w0rxbend/worxboard-ergo/docs/README.md

# Documentation

Revision A0 is an engineering preview. The case can be printed. The PCB cannot be ordered.

## Guides

| Page | Use it to |
|---|---|
| [3D print guide](printing.md) | Print the case: files, bed sizes, orientation, test pieces, screws |
| [Build guide](build.md) | Follow the whole shop and bench sequence, including what is blocked |
| [CNC traveler](cnc.md) | Mill the chassis and plate from the STEP files |
| [Assembly plan](assembly.md) | See the order of prototype steps and their gates |
| [Firmware notes](firmware.md) | Build the pinned ZMK image and read the controls |

## Design record

| Page | What it records |
|---|---|
| [Design](design.md) | The layout, the shell, and every case dimension |
| [Electrical](electrical.md) | USB port selection, power, and the flashing override |
| [KiCad seed](pcb-seed.md) | How the unrouted boards are generated |
| [Launch coverage](launch-coverage.md) | What does and does not carry over from System76 Launch |
| [Sources](sources.md) | Upstream references and their pins |
| [BOM](bom.csv) | An illustrative parts list. Not for ordering |

## Evidence

| Page | What it answers |
|---|---|
| [Verification](verification.md) | What has been checked, how, and what has not |
| [Roadmap](roadmap.md) | The gates from A0 to a manufacturing package |
| [Changelog](../CHANGELOG.md) | What changed in each release |
