w0rxbend/worxboard-ergo/docs/electrical.md

# Electronics and USB architecture

A bare RP2040 scans a 4×15 matrix with one 1N4148W diode per key: 48 keys fill ROW0–2 and three places of ROW3. Column -> switch -> diode anode -> diode cathode -> row gives `col2row`. Rows GP0–3 are inputs with pull-down; columns COL0–1 on GP26–27 and COL2–14 on GP8–20 are outputs. GP4 and GP28 are left unconnected. `tools/firmware_layout.py` writes the matrix and display pins of the ZMK board files from `GPIO_NETS` in `pcb/scripts/design.py`. A W25Q128JVSIQ provides 16 MiB of QSPI flash; the final 512 KiB is reserved for settings. A 12 MHz crystal, RP2040 supply decoupling, AP2112K 3.3 V regulator, reset, BOOT and SWD test points are included in the schematic.

| GPIO | Function |
|---|---|
| 0–3 | Matrix ROW0–3 |
| 4 | Not connected |
| 5 / 6 / 7 | LCD CS (active high) / SPI0 SCK / SPI0 MOSI |
| 8–20 | Matrix COL2–14 |
| 21 / 22 | USB mux SEL0 / SEL1 |
| 23 / 24 / 25 | Left / center / right pre-diode VBUS sense |
| 26 / 27 | Matrix COL0 / COL1 |
| 28 | Not connected |
| 29 | Reserved RGB output header; not enabled in firmware |

Each USB-C receptacle has independent CC1/CC2 5.1 kΩ sink resistors, its own D+/D− ESD clamp, and a B5819W diode from its VBUS to VSYS. No host VBUS rails are directly tied. The diode OR permits the controller to remain powered if several inputs are connected. Diode leakage, voltage drop, attach current and transient behavior need measurement; this is not a certified multi-host product. Ground is common; there is no galvanic isolation.

A TI TS3USB3031 isolates the three USB data pairs. Its datasheet truth table is `SEL1:SEL0 = 00 left, 01 center, 10 right, 11 high impedance`. The third differential path is labelled MHL+/− by TI; USB full-speed operation on that path still needs bench verification. Both selector bits have 10 kΩ pull-ups, so the default state is disconnected while RP2040 resets. Each pre-diode VBUS rail is divided by 5.1 kΩ/5.1 kΩ for GPIO detection; the 10.2 kΩ to ground also bleeds Schottky reverse leakage on an unplugged port. At a nominal 5 V input this is 2.5 V; verify input thresholds across supply/tolerance extremes.

The ZMK module polls VBUS, uses the center/left/right priority only when choosing a new input, and retains a selected powered input. It enters high impedance for 25 ms before selecting another input. Masked GPIO writes change both selection bits together. This behavior is tested on the host and compiled for RP2040, but actual mux switching, host enumeration and reconnect behavior require hardware. It is cable-position selection, not a KVM feature or simultaneous multi-host keyboard.

USB inputs operate at USB 2.0 full speed through the RP2040 PHY. No PD, charging, USB 3.x, or peripheral hub is included. The 27 Ω USB series resistors belong close to the RP2040. Each receptacle pair runs on F.Cu over the solid In1.Cu ground plane, 0.22 mm wide with a 0.15 mm gap: about 90 Ω differential on PCBWay's standard 4-layer 1.6 mm build by the IPC-2141A closed form (see `pcb/scripts/rules.py`). The second receptacle pad of each line and the ESD clamp join the pair within a few millimetres of the receptacle. This is a computed figure, not a measured one.

The committed `.kicad_pcb` files have placed parts and **zero tracks**. Routing is in progress; [verification.md](verification.md) records where it stands. There is no fabrication package. No board has been built.

The plate has a 2.6 × 1.1 mm window south of every switch for a later SK6812MINI-E. The schematic does not stuff that chain. GP4 and GP28 are free on this board and could drive a load-switch enable in a later revision; none is fitted. Forty-eight addressable LEDs at about 1 mA each would exceed the 2.5 mA USB suspend budget even when dark, and full-white current is far beyond USB 2.0. The RGB header still exposes VSYS, GP29 and ground for a bench experiment. A populated chain needs a level shifter, per-LED decoupling, a default-off power switch, and a measured current limit before it can be routed. Do not attach an unrestricted LED chain directly to this header.

J6 and J7 are SPDT slide switches (C&K PCM12SMTR, 1.4 mm tall) on the bottom of the board; pin 2 of each is the common. Set both to the 1–2 side (RUN) for normal firmware selection. For ROM flashing, disconnect USB, set both to the 2–3 side (ROM), and use only the center USB input. This fixes SEL0=1 and SEL1=0 while disconnecting the firmware control signals, so ROM USB can work without executing the selector code. Hold BOOT while pressing RESET, then copy UF2 to RPI-RP2. Disconnect USB before setting both back to RUN. The switches are reachable only with the board out of the chassis. Both settings and the throw direction on the flipped footprint must be checked during A1; SWD remains the first bring-up/recovery method. The 1 kΩ firmware-side resistors also limit drive contention while a switch is between positions.

The UF2 is a compiled development artifact, not a claim of working hardware. Do not move J6 or J7 while the board is powered.

```mermaid
flowchart LR
  L[Left USB-C] --> M[3:1 USB data mux]
  C[Center USB-C] --> M
  R[Right USB-C] --> M
  M --> RP[RP2040 + QSPI flash]
  RP --> K[4 x 15 diode matrix]
  RP --> D[Center SPI memory LCD]
  L --> VL[VBUS isolation diode]
  C --> VC[VBUS isolation diode]
  R --> VR[VBUS isolation diode]
  VL --> VS[VSYS / 3.3 V regulator]
  VC --> VS
  VR --> VS
  VS --> RP
```
