w0rxbend/worxboard-ergo/assets/layout.png

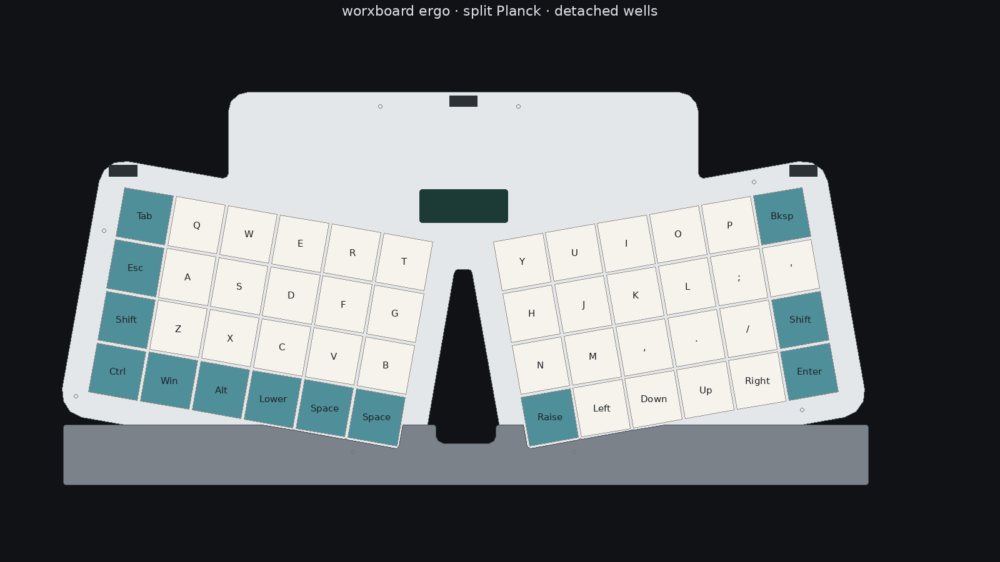
assets/layout.png
