w0rxbend/worxboard-ergo/cad/exports/laser/chassis-underside.png

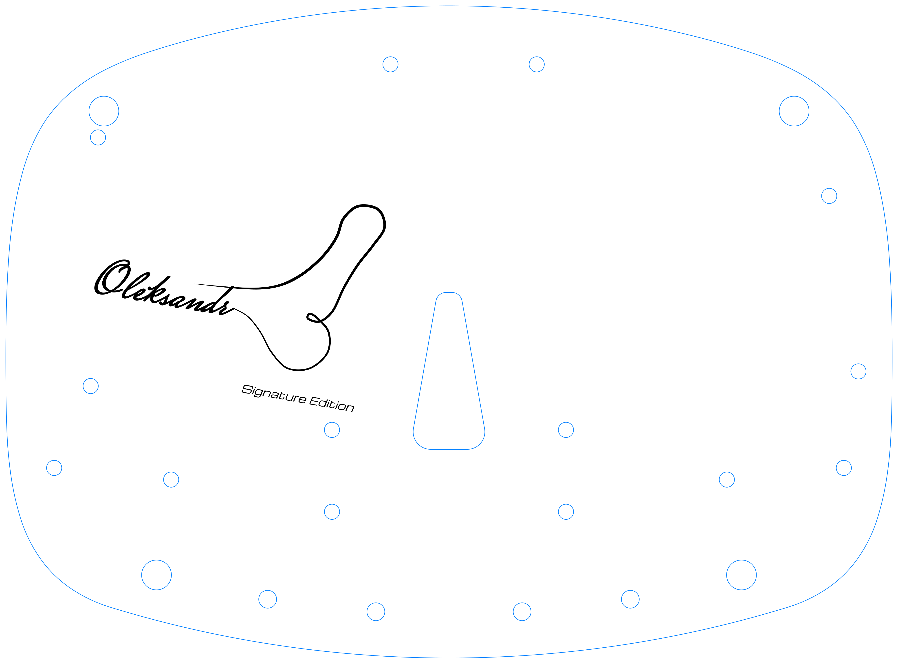
cad/exports/laser/chassis-underside.png
