w0rxbend/worxboard-ergo/cad/exports/laser/signature.png

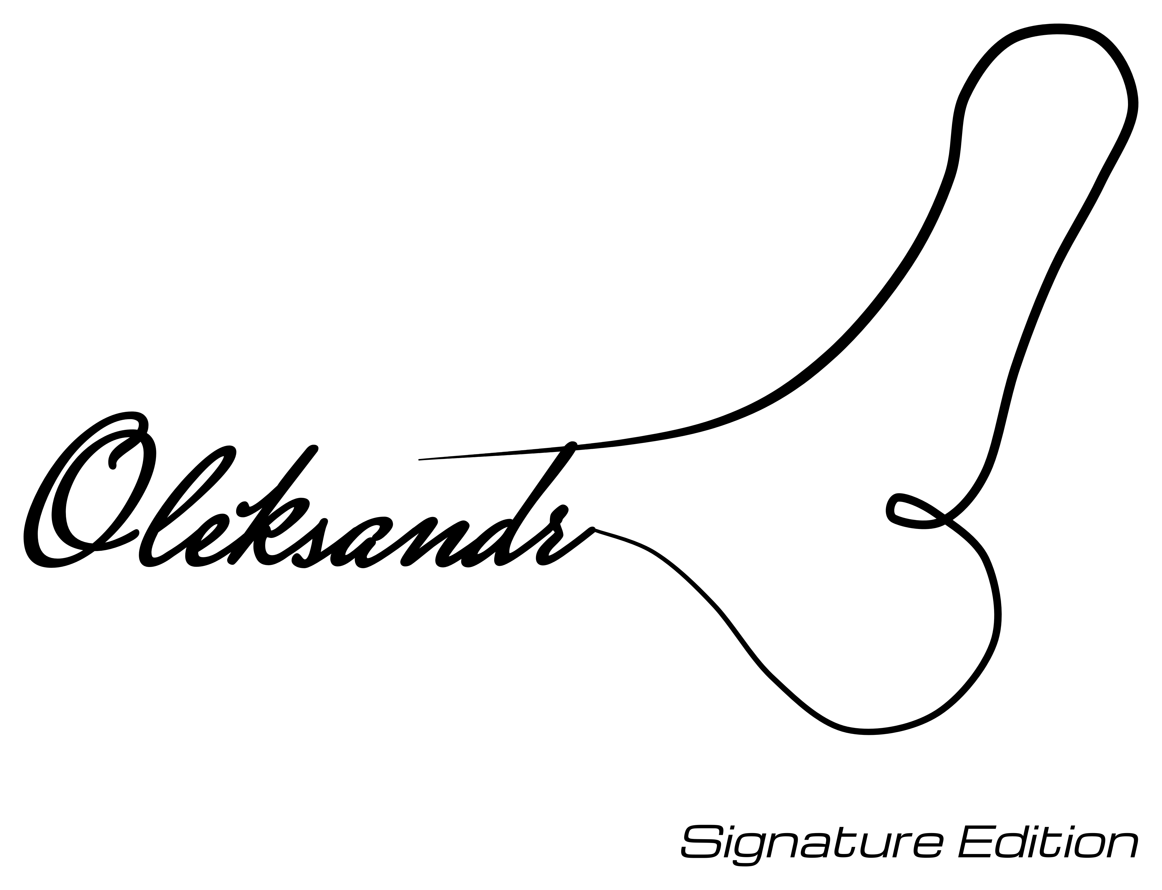
cad/exports/laser/signature.png
