w0rxbend/worxboard-ergo/site/img/choc.png

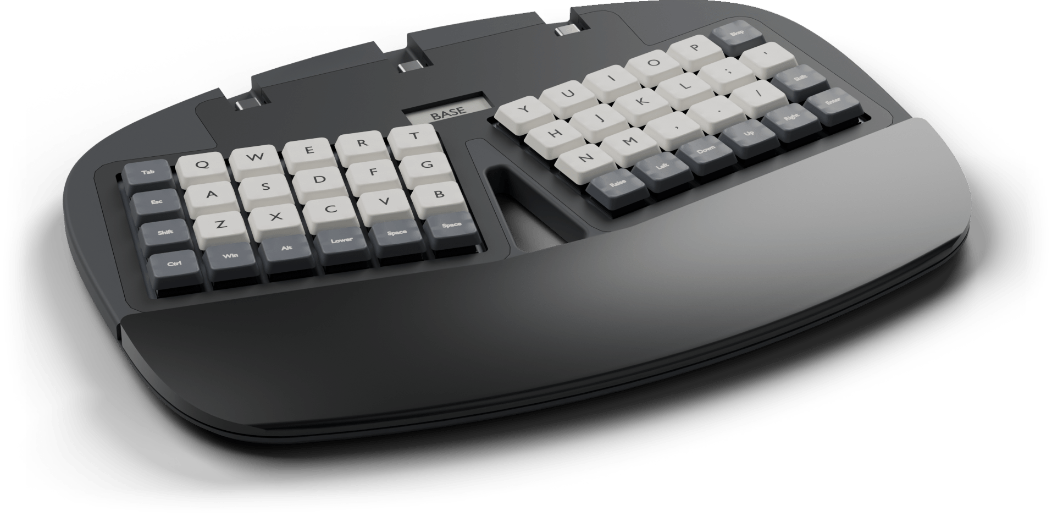
site/img/choc.png
