w0rxbend/worxboard-ergo/site/img/detail-display.png

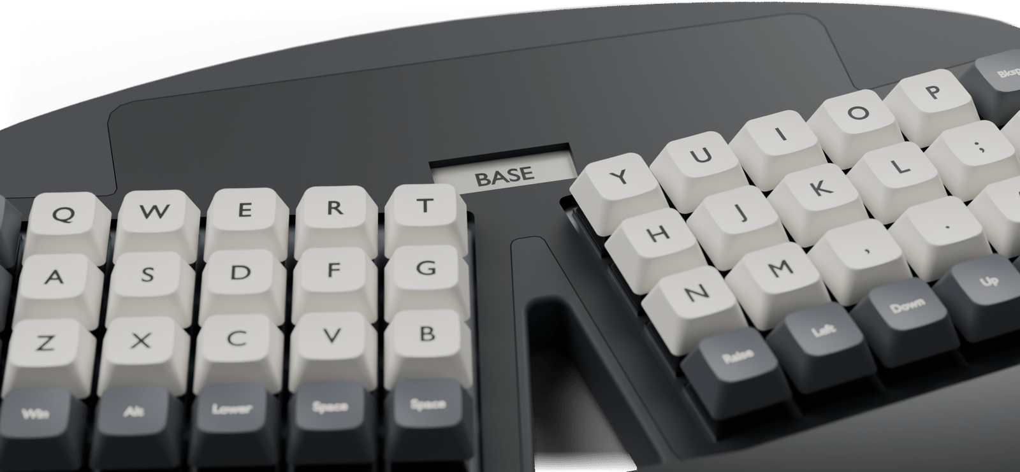
site/img/detail-display.png
