w0rxbend/worxboard-ergo/site/img/detail-legends.png

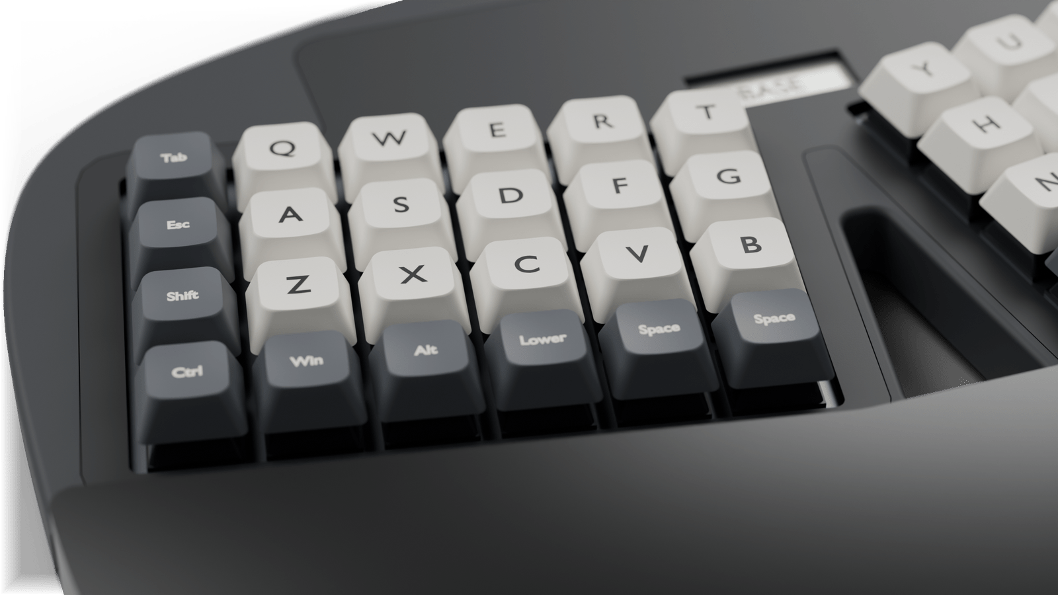
site/img/detail-legends.png
