w0rxbend/worxboard-ergo/site/img/detail-palm.png

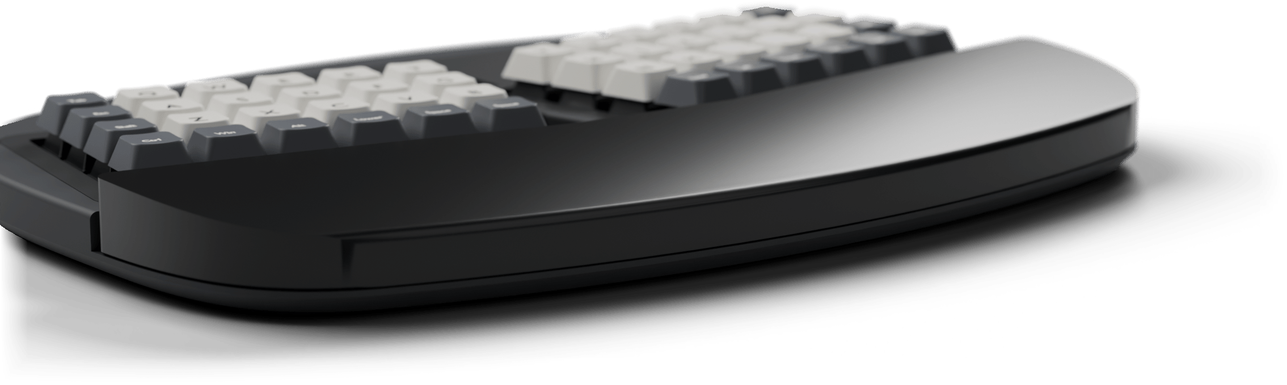
site/img/detail-palm.png
