w0rxbend/worxboard-ergo/site/img/hero.png

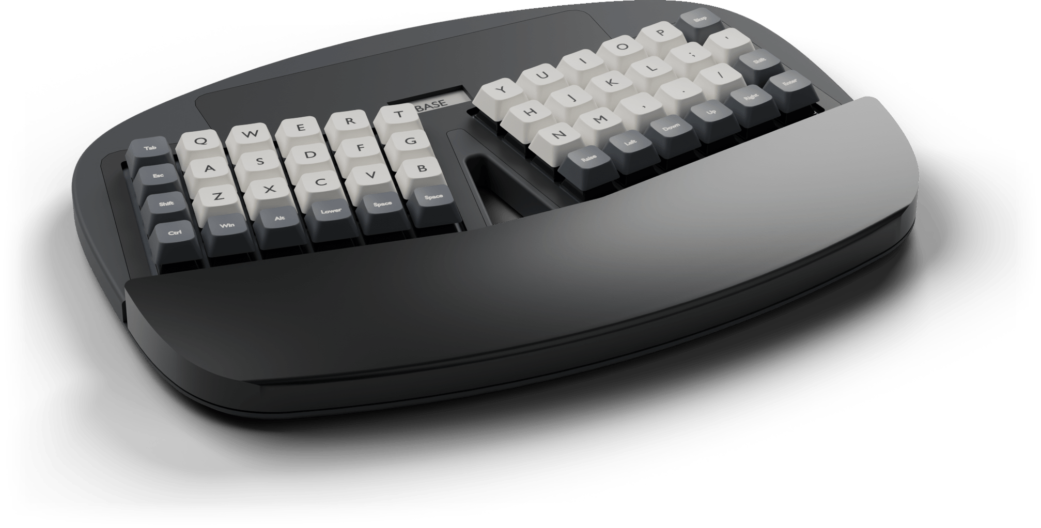
site/img/hero.png
