w0rxbend/worxboard-ergo/site/img/rear.png

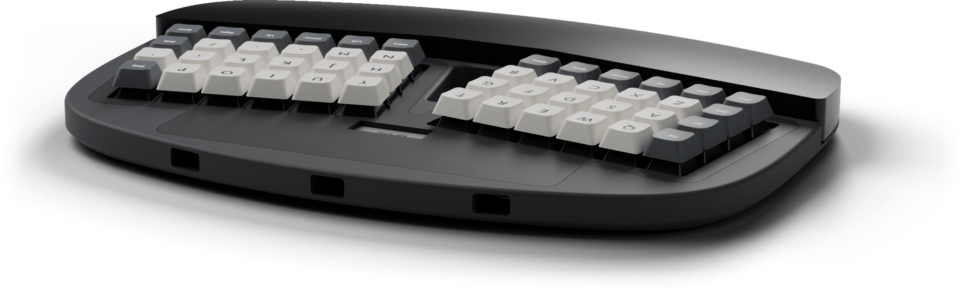
site/img/rear.png
