w0rxbend/worxboard-ergo/site/img/riser.png

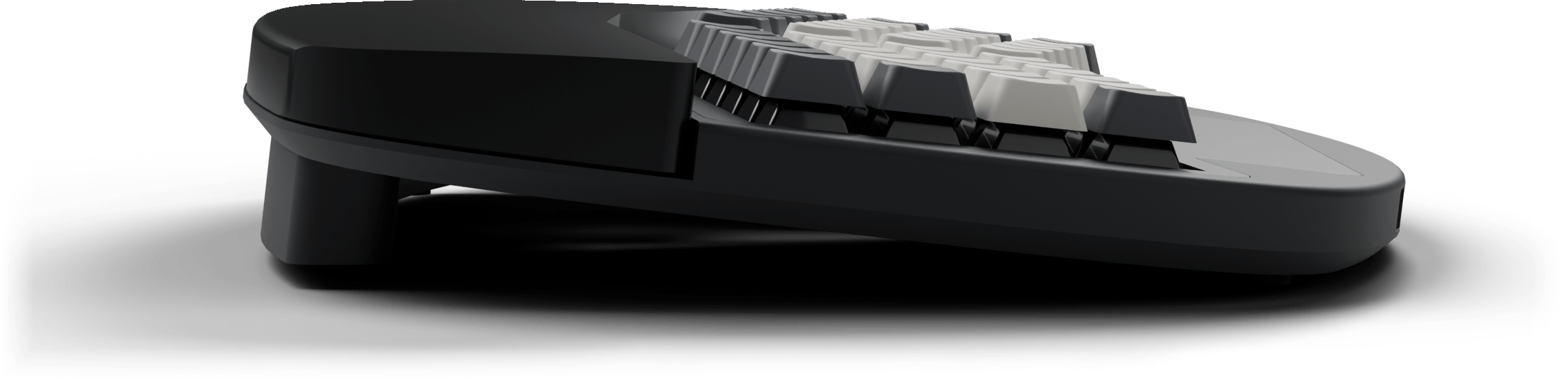
site/img/riser.png
