w0rxbend/worxboard-ergo/site/img/side.png

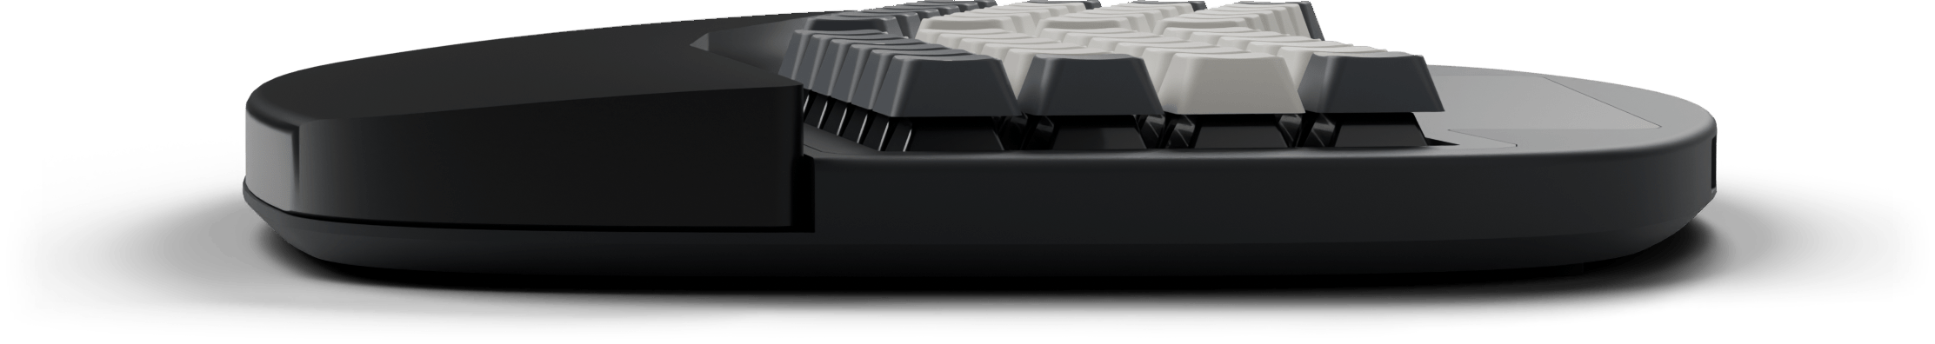
site/img/side.png
