w0rxbend/worxboard-ergo/site/img/top.png

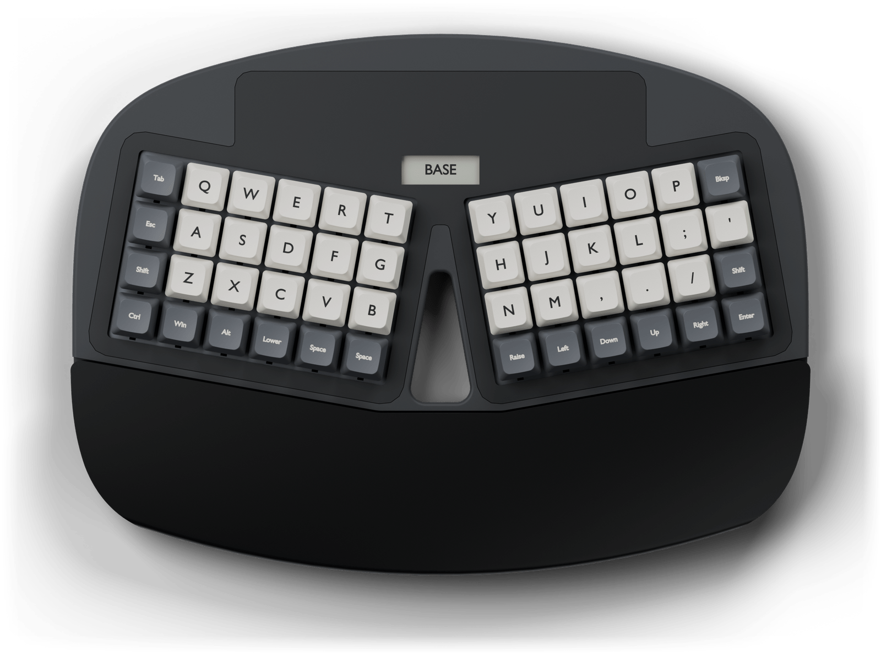
site/img/top.png
