w0rxbend/worxboard-ergo/docs/bom.csv

variant | reference | value | footprint | manufacturer | mpn | LCSC_reference_only | group | fitted_by | status
mx | U1 | RP2040 | Package_DFN_QFN:QFN-56-1EP_7x7mm_P0.4mm_EP3.2x3.2mm | Raspberry Pi | RP2040 | C2040 | MCU | assembler | MPN_READ_2026-11-13_STOCK_AND_PRICE_UNKNOWN
mx | U2 | W25Q128JVSIQ | Package_SO:SOIC-8_5.3x5.3mm_P1.27mm | Winbond | W25Q128JVSIQ | C97521 | MCU | assembler | MPN_READ_2026-11-13_STOCK_AND_PRICE_UNKNOWN
mx | C5 | 100n | Capacitor_SMD:C_0402_1005Metric | Samsung Electro-Mechanics | CL05B104KO5NNNC | C1525 | MCU | assembler | MPN_READ_2026-11-13_STOCK_AND_PRICE_UNKNOWN
mx | Y1 | 12MHz | Crystal:Crystal_SMD_3225-4Pin_3.2x2.5mm | YXC | XL2EL89CRI-111YLC-12M | C49304726 | MCU | assembler | MPN_READ_2026-11-13_STOCK_AND_PRICE_UNKNOWN
mx | R7 | 1k | Resistor_SMD:R_0402_1005Metric | UNI-ROYAL | 0402WGF1001TCE | C11702 | MCU | assembler | MPN_READ_2026-11-13_STOCK_AND_PRICE_UNKNOWN
mx | C6 | 27p | Capacitor_SMD:C_0402_1005Metric | Fenghua | 0402CG270J500NT | C1557 | MCU | assembler | MPN_READ_2026-11-13_STOCK_AND_PRICE_UNKNOWN
mx | C7 | 27p | Capacitor_SMD:C_0402_1005Metric | Fenghua | 0402CG270J500NT | C1557 | MCU | assembler | MPN_READ_2026-11-13_STOCK_AND_PRICE_UNKNOWN
mx | R8 | 10k | Resistor_SMD:R_0402_1005Metric | UNI-ROYAL | 0402WGF1002TCE | C25744 | MCU | assembler | MPN_READ_2026-11-13_STOCK_AND_PRICE_UNKNOWN
mx | R9 | 1k | Resistor_SMD:R_0402_1005Metric | UNI-ROYAL | 0402WGF1001TCE | C11702 | MCU | assembler | MPN_READ_2026-11-13_STOCK_AND_PRICE_UNKNOWN
mx | SW1 | BOOT | Button_Switch_SMD:SW_SPST_TS-1088-xR020 | XUNPU | TS-1088R-02026 | C455280 | MCU | assembler | MPN_READ_2026-11-13_STOCK_AND_PRICE_UNKNOWN
mx | R10 | 10k | Resistor_SMD:R_0402_1005Metric | UNI-ROYAL | 0402WGF1002TCE | C25744 | MCU | assembler | MPN_READ_2026-11-13_STOCK_AND_PRICE_UNKNOWN
mx | SW2 | RESET | Button_Switch_SMD:SW_SPST_TS-1088-xR020 | XUNPU | TS-1088R-02026 | C455280 | MCU | assembler | MPN_READ_2026-11-13_STOCK_AND_PRICE_UNKNOWN
mx | C8 | 100n | Capacitor_SMD:C_0402_1005Metric | Samsung Electro-Mechanics | CL05B104KO5NNNC | C1525 | MCU | assembler | MPN_READ_2026-11-13_STOCK_AND_PRICE_UNKNOWN
mx | C9 | 100n | Capacitor_SMD:C_0402_1005Metric | Samsung Electro-Mechanics | CL05B104KO5NNNC | C1525 | MCU | assembler | MPN_READ_2026-11-13_STOCK_AND_PRICE_UNKNOWN
mx | C10 | 100n | Capacitor_SMD:C_0402_1005Metric | Samsung Electro-Mechanics | CL05B104KO5NNNC | C1525 | MCU | assembler | MPN_READ_2026-11-13_STOCK_AND_PRICE_UNKNOWN
mx | C11 | 100n | Capacitor_SMD:C_0402_1005Metric | Samsung Electro-Mechanics | CL05B104KO5NNNC | C1525 | MCU | assembler | MPN_READ_2026-11-13_STOCK_AND_PRICE_UNKNOWN
mx | C12 | 100n | Capacitor_SMD:C_0402_1005Metric | Samsung Electro-Mechanics | CL05B104KO5NNNC | C1525 | MCU | assembler | MPN_READ_2026-11-13_STOCK_AND_PRICE_UNKNOWN
mx | C13 | 100n | Capacitor_SMD:C_0402_1005Metric | Samsung Electro-Mechanics | CL05B104KO5NNNC | C1525 | MCU | assembler | MPN_READ_2026-11-13_STOCK_AND_PRICE_UNKNOWN
mx | C14 | 100n | Capacitor_SMD:C_0402_1005Metric | Samsung Electro-Mechanics | CL05B104KO5NNNC | C1525 | MCU | assembler | MPN_READ_2026-11-13_STOCK_AND_PRICE_UNKNOWN
mx | C15 | 100n | Capacitor_SMD:C_0402_1005Metric | Samsung Electro-Mechanics | CL05B104KO5NNNC | C1525 | MCU | assembler | MPN_READ_2026-11-13_STOCK_AND_PRICE_UNKNOWN
mx | C16 | 100n | Capacitor_SMD:C_0402_1005Metric | Samsung Electro-Mechanics | CL05B104KO5NNNC | C1525 | MCU | assembler | MPN_READ_2026-11-13_STOCK_AND_PRICE_UNKNOWN
mx | C17 | 100n | Capacitor_SMD:C_0402_1005Metric | Samsung Electro-Mechanics | CL05B104KO5NNNC | C1525 | MCU | assembler | MPN_READ_2026-11-13_STOCK_AND_PRICE_UNKNOWN
mx | C18 | 1u | Capacitor_SMD:C_0402_1005Metric | Samsung Electro-Mechanics | CL05A105KA5NQNC | C52923 | MCU | assembler | MPN_READ_2026-11-13_STOCK_AND_PRICE_UNKNOWN
mx | C19 | 1u | Capacitor_SMD:C_0402_1005Metric | Samsung Electro-Mechanics | CL05A105KA5NQNC | C52923 | MCU | assembler | MPN_READ_2026-11-13_STOCK_AND_PRICE_UNKNOWN
mx | J1 | TYPE-C-31-M-12 | Connector_USB:USB_C_Receptacle_HRO_TYPE-C-31-M-12 | Korean Hroparts Elec | TYPE-C-31-M-12 | C165948 | USB-POWER | assembler | MPN_READ_2026-11-13_STOCK_AND_PRICE_UNKNOWN
mx | R25 | 5.1k | Resistor_SMD:R_0402_1005Metric | UNI-ROYAL | 0402WGF5101TCE | C25905 | USB-POWER | assembler | MPN_READ_2026-11-13_STOCK_AND_PRICE_UNKNOWN
mx | R26 | 5.1k | Resistor_SMD:R_0402_1005Metric | UNI-ROYAL | 0402WGF5101TCE | C25905 | USB-POWER | assembler | MPN_READ_2026-11-13_STOCK_AND_PRICE_UNKNOWN
mx | R27 | 5.1k | Resistor_SMD:R_0402_1005Metric | UNI-ROYAL | 0402WGF5101TCE | C25905 | USB-POWER | assembler | MPN_READ_2026-11-13_STOCK_AND_PRICE_UNKNOWN
mx | R28 | 5.1k | Resistor_SMD:R_0402_1005Metric | UNI-ROYAL | 0402WGF5101TCE | C25905 | USB-POWER | assembler | MPN_READ_2026-11-13_STOCK_AND_PRICE_UNKNOWN
mx | D1 | B5819W | Diode_SMD:D_SOD-123 | JSCJ | B5819W SL | C8598 | USB-POWER | assembler | MPN_READ_2026-11-13_STOCK_AND_PRICE_UNKNOWN
mx | U4 | USBLC6-2SC6 | Package_TO_SOT_SMD:SOT-23-6 | STMicroelectronics | USBLC6-2SC6 | C7519 | USB-POWER | assembler | MPN_READ_2026-11-13_STOCK_AND_PRICE_UNKNOWN
mx | J2 | TYPE-C-31-M-12 | Connector_USB:USB_C_Receptacle_HRO_TYPE-C-31-M-12 | Korean Hroparts Elec | TYPE-C-31-M-12 | C165948 | USB-POWER | assembler | MPN_READ_2026-11-13_STOCK_AND_PRICE_UNKNOWN
mx | R30 | 5.1k | Resistor_SMD:R_0402_1005Metric | UNI-ROYAL | 0402WGF5101TCE | C25905 | USB-POWER | assembler | MPN_READ_2026-11-13_STOCK_AND_PRICE_UNKNOWN
mx | R31 | 5.1k | Resistor_SMD:R_0402_1005Metric | UNI-ROYAL | 0402WGF5101TCE | C25905 | USB-POWER | assembler | MPN_READ_2026-11-13_STOCK_AND_PRICE_UNKNOWN
mx | R32 | 5.1k | Resistor_SMD:R_0402_1005Metric | UNI-ROYAL | 0402WGF5101TCE | C25905 | USB-POWER | assembler | MPN_READ_2026-11-13_STOCK_AND_PRICE_UNKNOWN
mx | R33 | 5.1k | Resistor_SMD:R_0402_1005Metric | UNI-ROYAL | 0402WGF5101TCE | C25905 | USB-POWER | assembler | MPN_READ_2026-11-13_STOCK_AND_PRICE_UNKNOWN
mx | D2 | B5819W | Diode_SMD:D_SOD-123 | JSCJ | B5819W SL | C8598 | USB-POWER | assembler | MPN_READ_2026-11-13_STOCK_AND_PRICE_UNKNOWN
mx | U5 | USBLC6-2SC6 | Package_TO_SOT_SMD:SOT-23-6 | STMicroelectronics | USBLC6-2SC6 | C7519 | USB-POWER | assembler | MPN_READ_2026-11-13_STOCK_AND_PRICE_UNKNOWN
mx | J3 | TYPE-C-31-M-12 | Connector_USB:USB_C_Receptacle_HRO_TYPE-C-31-M-12 | Korean Hroparts Elec | TYPE-C-31-M-12 | C165948 | USB-POWER | assembler | MPN_READ_2026-11-13_STOCK_AND_PRICE_UNKNOWN
mx | R35 | 5.1k | Resistor_SMD:R_0402_1005Metric | UNI-ROYAL | 0402WGF5101TCE | C25905 | USB-POWER | assembler | MPN_READ_2026-11-13_STOCK_AND_PRICE_UNKNOWN
mx | R36 | 5.1k | Resistor_SMD:R_0402_1005Metric | UNI-ROYAL | 0402WGF5101TCE | C25905 | USB-POWER | assembler | MPN_READ_2026-11-13_STOCK_AND_PRICE_UNKNOWN
mx | R37 | 5.1k | Resistor_SMD:R_0402_1005Metric | UNI-ROYAL | 0402WGF5101TCE | C25905 | USB-POWER | assembler | MPN_READ_2026-11-13_STOCK_AND_PRICE_UNKNOWN
mx | R38 | 5.1k | Resistor_SMD:R_0402_1005Metric | UNI-ROYAL | 0402WGF5101TCE | C25905 | USB-POWER | assembler | MPN_READ_2026-11-13_STOCK_AND_PRICE_UNKNOWN
mx | D3 | B5819W | Diode_SMD:D_SOD-123 | JSCJ | B5819W SL | C8598 | USB-POWER | assembler | MPN_READ_2026-11-13_STOCK_AND_PRICE_UNKNOWN
mx | U6 | USBLC6-2SC6 | Package_TO_SOT_SMD:SOT-23-6 | STMicroelectronics | USBLC6-2SC6 | C7519 | USB-POWER | assembler | MPN_READ_2026-11-13_STOCK_AND_PRICE_UNKNOWN
mx | U3 | AP2112K-3.3 | Package_TO_SOT_SMD:SOT-23-5 | Diodes Incorporated | AP2112K-3.3TRG1 | C51118 | USB-POWER | assembler | MPN_READ_2026-11-13_STOCK_AND_PRICE_UNKNOWN
mx | C1 | 1u | Capacitor_SMD:C_0402_1005Metric | Samsung Electro-Mechanics | CL05A105KA5NQNC | C52923 | USB-POWER | assembler | MPN_READ_2026-11-13_STOCK_AND_PRICE_UNKNOWN
mx | C2 | 1u | Capacitor_SMD:C_0402_1005Metric | Samsung Electro-Mechanics | CL05A105KA5NQNC | C52923 | USB-POWER | assembler | MPN_READ_2026-11-13_STOCK_AND_PRICE_UNKNOWN
mx | C3 | 10u | Capacitor_SMD:C_0402_1005Metric | Samsung Electro-Mechanics | CL05A106MQ5NUNC | C15525 | USB-POWER | assembler | MPN_READ_2026-11-13_STOCK_AND_PRICE_UNKNOWN
mx | C4 | 1u | Capacitor_SMD:C_0402_1005Metric | Samsung Electro-Mechanics | CL05A105KA5NQNC | C52923 | USB-POWER | assembler | MPN_READ_2026-11-13_STOCK_AND_PRICE_UNKNOWN
mx | R3 | 27 | Resistor_SMD:R_0402_1005Metric | FOJAN | FRC0402F27R0TS | C2909343 | USB-POWER | assembler | MPN_READ_2026-11-13_STOCK_AND_PRICE_UNKNOWN
mx | R4 | 27 | Resistor_SMD:R_0402_1005Metric | FOJAN | FRC0402F27R0TS | C2909343 | USB-POWER | assembler | MPN_READ_2026-11-13_STOCK_AND_PRICE_UNKNOWN
mx | U7 | TS3USB3031RMGR | Package_DFN_QFN:Texas_RMG0012A_WQFN-12_1.8x1.8mm_P0.4mm | Texas Instruments | TS3USB3031RMGR | C2652459 | SELECTOR | assembler | MPN_READ_2026-11-13_STOCK_AND_PRICE_UNKNOWN
mx | R40 | 10k | Resistor_SMD:R_0402_1005Metric | UNI-ROYAL | 0402WGF1002TCE | C25744 | SELECTOR | assembler | MPN_READ_2026-11-13_STOCK_AND_PRICE_UNKNOWN
mx | R41 | 10k | Resistor_SMD:R_0402_1005Metric | UNI-ROYAL | 0402WGF1002TCE | C25744 | SELECTOR | assembler | MPN_READ_2026-11-13_STOCK_AND_PRICE_UNKNOWN
mx | C20 | 100n | Capacitor_SMD:C_0402_1005Metric | Samsung Electro-Mechanics | CL05B104KO5NNNC | C1525 | SELECTOR | assembler | MPN_READ_2026-11-13_STOCK_AND_PRICE_UNKNOWN
mx | R42 | 1k | Resistor_SMD:R_0402_1005Metric | UNI-ROYAL | 0402WGF1001TCE | C11702 | SELECTOR | assembler | MPN_READ_2026-11-13_STOCK_AND_PRICE_UNKNOWN
mx | R43 | 1k | Resistor_SMD:R_0402_1005Metric | UNI-ROYAL | 0402WGF1001TCE | C11702 | SELECTOR | assembler | MPN_READ_2026-11-13_STOCK_AND_PRICE_UNKNOWN
mx | J6 | SEL0: RUN 1-2 / ROM 2-3 | Button_Switch_SMD:SW_SPDT_PCM12 | C&K | PCM12SMTR | C221841 | SELECTOR | assembler | MPN_READ_2026-11-13_STOCK_AND_PRICE_UNKNOWN
mx | J7 | SEL1: RUN 1-2 / ROM 2-3 | Button_Switch_SMD:SW_SPDT_PCM12 | C&K | PCM12SMTR | C221841 | SELECTOR | assembler | MPN_READ_2026-11-13_STOCK_AND_PRICE_UNKNOWN
mx | J4 | nice!view SPI LCD | worxboard:PinSocket_1x05_P2.54mm_Vertical_H5.0mm | HJ Tech | 17-0004-002 |  | DISPLAY | customer | UNVERIFIED_NOT_FOR_ORDER
mx | J5 | RGB expansion (3V3 logic) | Connector_JST:JST_SH_SM03B-SRSS-TB_1x03-1MP_P1.00mm_Horizontal | JST | SM03B-SRSS-TB(LF)(SN) | C160403 | DISPLAY | assembler | MPN_READ_2026-11-13_STOCK_AND_PRICE_UNKNOWN
mx | SK101 | MX | worxboard:SW_MX_Hotswap_Kailh | Kailh | CPG151101S11 | C2803348 | MATRIX | assembler | MPN_READ_2026-11-13_STOCK_AND_PRICE_UNKNOWN
mx | D101 | 1N4148W | Diode_SMD:D_SOD-123 | ST (Semtech), as LCSC lists it | 1N4148W | C81598 | MATRIX | assembler | MPN_READ_2026-11-13_STOCK_AND_PRICE_UNKNOWN
mx | SK102 | MX | worxboard:SW_MX_Hotswap_Kailh | Kailh | CPG151101S11 | C2803348 | MATRIX | assembler | MPN_READ_2026-11-13_STOCK_AND_PRICE_UNKNOWN
mx | D102 | 1N4148W | Diode_SMD:D_SOD-123 | ST (Semtech), as LCSC lists it | 1N4148W | C81598 | MATRIX | assembler | MPN_READ_2026-11-13_STOCK_AND_PRICE_UNKNOWN
mx | SK103 | MX | worxboard:SW_MX_Hotswap_Kailh | Kailh | CPG151101S11 | C2803348 | MATRIX | assembler | MPN_READ_2026-11-13_STOCK_AND_PRICE_UNKNOWN
mx | D103 | 1N4148W | Diode_SMD:D_SOD-123 | ST (Semtech), as LCSC lists it | 1N4148W | C81598 | MATRIX | assembler | MPN_READ_2026-11-13_STOCK_AND_PRICE_UNKNOWN
mx | SK104 | MX | worxboard:SW_MX_Hotswap_Kailh | Kailh | CPG151101S11 | C2803348 | MATRIX | assembler | MPN_READ_2026-11-13_STOCK_AND_PRICE_UNKNOWN
mx | D104 | 1N4148W | Diode_SMD:D_SOD-123 | ST (Semtech), as LCSC lists it | 1N4148W | C81598 | MATRIX | assembler | MPN_READ_2026-11-13_STOCK_AND_PRICE_UNKNOWN
mx | SK105 | MX | worxboard:SW_MX_Hotswap_Kailh | Kailh | CPG151101S11 | C2803348 | MATRIX | assembler | MPN_READ_2026-11-13_STOCK_AND_PRICE_UNKNOWN
mx | D105 | 1N4148W | Diode_SMD:D_SOD-123 | ST (Semtech), as LCSC lists it | 1N4148W | C81598 | MATRIX | assembler | MPN_READ_2026-11-13_STOCK_AND_PRICE_UNKNOWN
mx | SK106 | MX | worxboard:SW_MX_Hotswap_Kailh | Kailh | CPG151101S11 | C2803348 | MATRIX | assembler | MPN_READ_2026-11-13_STOCK_AND_PRICE_UNKNOWN
mx | D106 | 1N4148W | Diode_SMD:D_SOD-123 | ST (Semtech), as LCSC lists it | 1N4148W | C81598 | MATRIX | assembler | MPN_READ_2026-11-13_STOCK_AND_PRICE_UNKNOWN
mx | SK107 | MX | worxboard:SW_MX_Hotswap_Kailh | Kailh | CPG151101S11 | C2803348 | MATRIX | assembler | MPN_READ_2026-11-13_STOCK_AND_PRICE_UNKNOWN
mx | D107 | 1N4148W | Diode_SMD:D_SOD-123 | ST (Semtech), as LCSC lists it | 1N4148W | C81598 | MATRIX | assembler | MPN_READ_2026-11-13_STOCK_AND_PRICE_UNKNOWN
mx | SK108 | MX | worxboard:SW_MX_Hotswap_Kailh | Kailh | CPG151101S11 | C2803348 | MATRIX | assembler | MPN_READ_2026-11-13_STOCK_AND_PRICE_UNKNOWN
mx | D108 | 1N4148W | Diode_SMD:D_SOD-123 | ST (Semtech), as LCSC lists it | 1N4148W | C81598 | MATRIX | assembler | MPN_READ_2026-11-13_STOCK_AND_PRICE_UNKNOWN
mx | SK109 | MX | worxboard:SW_MX_Hotswap_Kailh | Kailh | CPG151101S11 | C2803348 | MATRIX | assembler | MPN_READ_2026-11-13_STOCK_AND_PRICE_UNKNOWN
mx | D109 | 1N4148W | Diode_SMD:D_SOD-123 | ST (Semtech), as LCSC lists it | 1N4148W | C81598 | MATRIX | assembler | MPN_READ_2026-11-13_STOCK_AND_PRICE_UNKNOWN
mx | SK110 | MX | worxboard:SW_MX_Hotswap_Kailh | Kailh | CPG151101S11 | C2803348 | MATRIX | assembler | MPN_READ_2026-11-13_STOCK_AND_PRICE_UNKNOWN
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
mx | D143 | 1N4148W | Diode_SMD:D_SOD-123 | ST (Semtech), as LCSC lists it | 1N4148W | C81598 | MATRIX | assembler | MPN_READ_2026-11-13_STOCK_AND_PRICE_UNKNOWN
mx | SK144 | MX | worxboard:SW_MX_Hotswap_Kailh | Kailh | CPG151101S11 | C2803348 | MATRIX | assembler | MPN_READ_2026-11-13_STOCK_AND_PRICE_UNKNOWN
mx | D144 | 1N4148W | Diode_SMD:D_SOD-123 | ST (Semtech), as LCSC lists it | 1N4148W | C81598 | MATRIX | assembler | MPN_READ_2026-11-13_STOCK_AND_PRICE_UNKNOWN
mx | SK145 | MX | worxboard:SW_MX_Hotswap_Kailh | Kailh | CPG151101S11 | C2803348 | MATRIX | assembler | MPN_READ_2026-11-13_STOCK_AND_PRICE_UNKNOWN
mx | D145 | 1N4148W | Diode_SMD:D_SOD-123 | ST (Semtech), as LCSC lists it | 1N4148W | C81598 | MATRIX | assembler | MPN_READ_2026-11-13_STOCK_AND_PRICE_UNKNOWN
mx | SK146 | MX | worxboard:SW_MX_Hotswap_Kailh | Kailh | CPG151101S11 | C2803348 | MATRIX | assembler | MPN_READ_2026-11-13_STOCK_AND_PRICE_UNKNOWN
mx | D146 | 1N4148W | Diode_SMD:D_SOD-123 | ST (Semtech), as LCSC lists it | 1N4148W | C81598 | MATRIX | assembler | MPN_READ_2026-11-13_STOCK_AND_PRICE_UNKNOWN
mx | SK147 | MX | worxboard:SW_MX_Hotswap_Kailh | Kailh | CPG151101S11 | C2803348 | MATRIX | assembler | MPN_READ_2026-11-13_STOCK_AND_PRICE_UNKNOWN
mx | D147 | 1N4148W | Diode_SMD:D_SOD-123 | ST (Semtech), as LCSC lists it | 1N4148W | C81598 | MATRIX | assembler | MPN_READ_2026-11-13_STOCK_AND_PRICE_UNKNOWN
mx | SK148 | MX | worxboard:SW_MX_Hotswap_Kailh | Kailh | CPG151101S11 | C2803348 | MATRIX | assembler | MPN_READ_2026-11-13_STOCK_AND_PRICE_UNKNOWN
mx | D148 | 1N4148W | Diode_SMD:D_SOD-123 | ST (Semtech), as LCSC lists it | 1N4148W | C81598 | MATRIX | assembler | MPN_READ_2026-11-13_STOCK_AND_PRICE_UNKNOWN
choc | U1 | RP2040 | Package_DFN_QFN:QFN-56-1EP_7x7mm_P0.4mm_EP3.2x3.2mm | Raspberry Pi | RP2040 | C2040 | MCU | assembler | MPN_READ_2026-11-13_STOCK_AND_PRICE_UNKNOWN
choc | U2 | W25Q128JVSIQ | Package_SO:SOIC-8_5.3x5.3mm_P1.27mm | Winbond | W25Q128JVSIQ | C97521 | MCU | assembler | MPN_READ_2026-11-13_STOCK_AND_PRICE_UNKNOWN
choc | C5 | 100n | Capacitor_SMD:C_0402_1005Metric | Samsung Electro-Mechanics | CL05B104KO5NNNC | C1525 | MCU | assembler | MPN_READ_2026-11-13_STOCK_AND_PRICE_UNKNOWN
choc | Y1 | 12MHz | Crystal:Crystal_SMD_3225-4Pin_3.2x2.5mm | YXC | XL2EL89CRI-111YLC-12M | C49304726 | MCU | assembler | MPN_READ_2026-11-13_STOCK_AND_PRICE_UNKNOWN
choc | R7 | 1k | Resistor_SMD:R_0402_1005Metric | UNI-ROYAL | 0402WGF1001TCE | C11702 | MCU | assembler | MPN_READ_2026-11-13_STOCK_AND_PRICE_UNKNOWN
choc | C6 | 27p | Capacitor_SMD:C_0402_1005Metric | Fenghua | 0402CG270J500NT | C1557 | MCU | assembler | MPN_READ_2026-11-13_STOCK_AND_PRICE_UNKNOWN
choc | C7 | 27p | Capacitor_SMD:C_0402_1005Metric | Fenghua | 0402CG270J500NT | C1557 | MCU | assembler | MPN_READ_2026-11-13_STOCK_AND_PRICE_UNKNOWN
choc | R8 | 10k | Resistor_SMD:R_0402_1005Metric | UNI-ROYAL | 0402WGF1002TCE | C25744 | MCU | assembler | MPN_READ_2026-11-13_STOCK_AND_PRICE_UNKNOWN
choc | R9 | 1k | Resistor_SMD:R_0402_1005Metric | UNI-ROYAL | 0402WGF1001TCE | C11702 | MCU | assembler | MPN_READ_2026-11-13_STOCK_AND_PRICE_UNKNOWN
choc | SW1 | BOOT | Button_Switch_SMD:SW_SPST_TS-1088-xR020 | XUNPU | TS-1088R-02026 | C455280 | MCU | assembler | MPN_READ_2026-11-13_STOCK_AND_PRICE_UNKNOWN
choc | R10 | 10k | Resistor_SMD:R_0402_1005Metric | UNI-ROYAL | 0402WGF1002TCE | C25744 | MCU | assembler | MPN_READ_2026-11-13_STOCK_AND_PRICE_UNKNOWN
choc | SW2 | RESET | Button_Switch_SMD:SW_SPST_TS-1088-xR020 | XUNPU | TS-1088R-02026 | C455280 | MCU | assembler | MPN_READ_2026-11-13_STOCK_AND_PRICE_UNKNOWN
choc | C8 | 100n | Capacitor_SMD:C_0402_1005Metric | Samsung Electro-Mechanics | CL05B104KO5NNNC | C1525 | MCU | assembler | MPN_READ_2026-11-13_STOCK_AND_PRICE_UNKNOWN
choc | C9 | 100n | Capacitor_SMD:C_0402_1005Metric | Samsung Electro-Mechanics | CL05B104KO5NNNC | C1525 | MCU | assembler | MPN_READ_2026-11-13_STOCK_AND_PRICE_UNKNOWN
choc | C10 | 100n | Capacitor_SMD:C_0402_1005Metric | Samsung Electro-Mechanics | CL05B104KO5NNNC | C1525 | MCU | assembler | MPN_READ_2026-11-13_STOCK_AND_PRICE_UNKNOWN
choc | C11 | 100n | Capacitor_SMD:C_0402_1005Metric | Samsung Electro-Mechanics | CL05B104KO5NNNC | C1525 | MCU | assembler | MPN_READ_2026-11-13_STOCK_AND_PRICE_UNKNOWN
choc | C12 | 100n | Capacitor_SMD:C_0402_1005Metric | Samsung Electro-Mechanics | CL05B104KO5NNNC | C1525 | MCU | assembler | MPN_READ_2026-11-13_STOCK_AND_PRICE_UNKNOWN
choc | C13 | 100n | Capacitor_SMD:C_0402_1005Metric | Samsung Electro-Mechanics | CL05B104KO5NNNC | C1525 | MCU | assembler | MPN_READ_2026-11-13_STOCK_AND_PRICE_UNKNOWN
choc | C14 | 100n | Capacitor_SMD:C_0402_1005Metric | Samsung Electro-Mechanics | CL05B104KO5NNNC | C1525 | MCU | assembler | MPN_READ_2026-11-13_STOCK_AND_PRICE_UNKNOWN
choc | C15 | 100n | Capacitor_SMD:C_0402_1005Metric | Samsung Electro-Mechanics | CL05B104KO5NNNC | C1525 | MCU | assembler | MPN_READ_2026-11-13_STOCK_AND_PRICE_UNKNOWN
choc | C16 | 100n | Capacitor_SMD:C_0402_1005Metric | Samsung Electro-Mechanics | CL05B104KO5NNNC | C1525 | MCU | assembler | MPN_READ_2026-11-13_STOCK_AND_PRICE_UNKNOWN
choc | C17 | 100n | Capacitor_SMD:C_0402_1005Metric | Samsung Electro-Mechanics | CL05B104KO5NNNC | C1525 | MCU | assembler | MPN_READ_2026-11-13_STOCK_AND_PRICE_UNKNOWN
choc | C18 | 1u | Capacitor_SMD:C_0402_1005Metric | Samsung Electro-Mechanics | CL05A105KA5NQNC | C52923 | MCU | assembler | MPN_READ_2026-11-13_STOCK_AND_PRICE_UNKNOWN
choc | C19 | 1u | Capacitor_SMD:C_0402_1005Metric | Samsung Electro-Mechanics | CL05A105KA5NQNC | C52923 | MCU | assembler | MPN_READ_2026-11-13_STOCK_AND_PRICE_UNKNOWN
choc | J1 | TYPE-C-31-M-12 | Connector_USB:USB_C_Receptacle_HRO_TYPE-C-31-M-12 | Korean Hroparts Elec | TYPE-C-31-M-12 | C165948 | USB-POWER | assembler | MPN_READ_2026-11-13_STOCK_AND_PRICE_UNKNOWN
choc | R25 | 5.1k | Resistor_SMD:R_0402_1005Metric | UNI-ROYAL | 0402WGF5101TCE | C25905 | USB-POWER | assembler | MPN_READ_2026-11-13_STOCK_AND_PRICE_UNKNOWN
choc | R26 | 5.1k | Resistor_SMD:R_0402_1005Metric | UNI-ROYAL | 0402WGF5101TCE | C25905 | USB-POWER | assembler | MPN_READ_2026-11-13_STOCK_AND_PRICE_UNKNOWN
choc | R27 | 5.1k | Resistor_SMD:R_0402_1005Metric | UNI-ROYAL | 0402WGF5101TCE | C25905 | USB-POWER | assembler | MPN_READ_2026-11-13_STOCK_AND_PRICE_UNKNOWN
choc | R28 | 5.1k | Resistor_SMD:R_0402_1005Metric | UNI-ROYAL | 0402WGF5101TCE | C25905 | USB-POWER | assembler | MPN_READ_2026-11-13_STOCK_AND_PRICE_UNKNOWN
choc | D1 | B5819W | Diode_SMD:D_SOD-123 | JSCJ | B5819W SL | C8598 | USB-POWER | assembler | MPN_READ_2026-11-13_STOCK_AND_PRICE_UNKNOWN
choc | U4 | USBLC6-2SC6 | Package_TO_SOT_SMD:SOT-23-6 | STMicroelectronics | USBLC6-2SC6 | C7519 | USB-POWER | assembler | MPN_READ_2026-11-13_STOCK_AND_PRICE_UNKNOWN
choc | J2 | TYPE-C-31-M-12 | Connector_USB:USB_C_Receptacle_HRO_TYPE-C-31-M-12 | Korean Hroparts Elec | TYPE-C-31-M-12 | C165948 | USB-POWER | assembler | MPN_READ_2026-11-13_STOCK_AND_PRICE_UNKNOWN
choc | R30 | 5.1k | Resistor_SMD:R_0402_1005Metric | UNI-ROYAL | 0402WGF5101TCE | C25905 | USB-POWER | assembler | MPN_READ_2026-11-13_STOCK_AND_PRICE_UNKNOWN
choc | R31 | 5.1k | Resistor_SMD:R_0402_1005Metric | UNI-ROYAL | 0402WGF5101TCE | C25905 | USB-POWER | assembler | MPN_READ_2026-11-13_STOCK_AND_PRICE_UNKNOWN
choc | R32 | 5.1k | Resistor_SMD:R_0402_1005Metric | UNI-ROYAL | 0402WGF5101TCE | C25905 | USB-POWER | assembler | MPN_READ_2026-11-13_STOCK_AND_PRICE_UNKNOWN
choc | R33 | 5.1k | Resistor_SMD:R_0402_1005Metric | UNI-ROYAL | 0402WGF5101TCE | C25905 | USB-POWER | assembler | MPN_READ_2026-11-13_STOCK_AND_PRICE_UNKNOWN
choc | D2 | B5819W | Diode_SMD:D_SOD-123 | JSCJ | B5819W SL | C8598 | USB-POWER | assembler | MPN_READ_2026-11-13_STOCK_AND_PRICE_UNKNOWN
choc | U5 | USBLC6-2SC6 | Package_TO_SOT_SMD:SOT-23-6 | STMicroelectronics | USBLC6-2SC6 | C7519 | USB-POWER | assembler | MPN_READ_2026-11-13_STOCK_AND_PRICE_UNKNOWN
choc | J3 | TYPE-C-31-M-12 | Connector_USB:USB_C_Receptacle_HRO_TYPE-C-31-M-12 | Korean Hroparts Elec | TYPE-C-31-M-12 | C165948 | USB-POWER | assembler | MPN_READ_2026-11-13_STOCK_AND_PRICE_UNKNOWN
choc | R35 | 5.1k | Resistor_SMD:R_0402_1005Metric | UNI-ROYAL | 0402WGF5101TCE | C25905 | USB-POWER | assembler | MPN_READ_2026-11-13_STOCK_AND_PRICE_UNKNOWN
choc | R36 | 5.1k | Resistor_SMD:R_0402_1005Metric | UNI-ROYAL | 0402WGF5101TCE | C25905 | USB-POWER | assembler | MPN_READ_2026-11-13_STOCK_AND_PRICE_UNKNOWN
choc | R37 | 5.1k | Resistor_SMD:R_0402_1005Metric | UNI-ROYAL | 0402WGF5101TCE | C25905 | USB-POWER | assembler | MPN_READ_2026-11-13_STOCK_AND_PRICE_UNKNOWN
choc | R38 | 5.1k | Resistor_SMD:R_0402_1005Metric | UNI-ROYAL | 0402WGF5101TCE | C25905 | USB-POWER | assembler | MPN_READ_2026-11-13_STOCK_AND_PRICE_UNKNOWN
choc | D3 | B5819W | Diode_SMD:D_SOD-123 | JSCJ | B5819W SL | C8598 | USB-POWER | assembler | MPN_READ_2026-11-13_STOCK_AND_PRICE_UNKNOWN
choc | U6 | USBLC6-2SC6 | Package_TO_SOT_SMD:SOT-23-6 | STMicroelectronics | USBLC6-2SC6 | C7519 | USB-POWER | assembler | MPN_READ_2026-11-13_STOCK_AND_PRICE_UNKNOWN
choc | U3 | AP2112K-3.3 | Package_TO_SOT_SMD:SOT-23-5 | Diodes Incorporated | AP2112K-3.3TRG1 | C51118 | USB-POWER | assembler | MPN_READ_2026-11-13_STOCK_AND_PRICE_UNKNOWN
choc | C1 | 1u | Capacitor_SMD:C_0402_1005Metric | Samsung Electro-Mechanics | CL05A105KA5NQNC | C52923 | USB-POWER | assembler | MPN_READ_2026-11-13_STOCK_AND_PRICE_UNKNOWN
choc | C2 | 1u | Capacitor_SMD:C_0402_1005Metric | Samsung Electro-Mechanics | CL05A105KA5NQNC | C52923 | USB-POWER | assembler | MPN_READ_2026-11-13_STOCK_AND_PRICE_UNKNOWN
choc | C3 | 10u | Capacitor_SMD:C_0402_1005Metric | Samsung Electro-Mechanics | CL05A106MQ5NUNC | C15525 | USB-POWER | assembler | MPN_READ_2026-11-13_STOCK_AND_PRICE_UNKNOWN
choc | C4 | 1u | Capacitor_SMD:C_0402_1005Metric | Samsung Electro-Mechanics | CL05A105KA5NQNC | C52923 | USB-POWER | assembler | MPN_READ_2026-11-13_STOCK_AND_PRICE_UNKNOWN
choc | R3 | 27 | Resistor_SMD:R_0402_1005Metric | FOJAN | FRC0402F27R0TS | C2909343 | USB-POWER | assembler | MPN_READ_2026-11-13_STOCK_AND_PRICE_UNKNOWN
choc | R4 | 27 | Resistor_SMD:R_0402_1005Metric | FOJAN | FRC0402F27R0TS | C2909343 | USB-POWER | assembler | MPN_READ_2026-11-13_STOCK_AND_PRICE_UNKNOWN
choc | U7 | TS3USB3031RMGR | Package_DFN_QFN:Texas_RMG0012A_WQFN-12_1.8x1.8mm_P0.4mm | Texas Instruments | TS3USB3031RMGR | C2652459 | SELECTOR | assembler | MPN_READ_2026-11-13_STOCK_AND_PRICE_UNKNOWN
choc | R40 | 10k | Resistor_SMD:R_0402_1005Metric | UNI-ROYAL | 0402WGF1002TCE | C25744 | SELECTOR | assembler | MPN_READ_2026-11-13_STOCK_AND_PRICE_UNKNOWN
choc | R41 | 10k | Resistor_SMD:R_0402_1005Metric | UNI-ROYAL | 0402WGF1002TCE | C25744 | SELECTOR | assembler | MPN_READ_2026-11-13_STOCK_AND_PRICE_UNKNOWN
choc | C20 | 100n | Capacitor_SMD:C_0402_1005Metric | Samsung Electro-Mechanics | CL05B104KO5NNNC | C1525 | SELECTOR | assembler | MPN_READ_2026-11-13_STOCK_AND_PRICE_UNKNOWN
choc | R42 | 1k | Resistor_SMD:R_0402_1005Metric | UNI-ROYAL | 0402WGF1001TCE | C11702 | SELECTOR | assembler | MPN_READ_2026-11-13_STOCK_AND_PRICE_UNKNOWN
choc | R43 | 1k | Resistor_SMD:R_0402_1005Metric | UNI-ROYAL | 0402WGF1001TCE | C11702 | SELECTOR | assembler | MPN_READ_2026-11-13_STOCK_AND_PRICE_UNKNOWN
choc | J6 | SEL0: RUN 1-2 / ROM 2-3 | Button_Switch_SMD:SW_SPDT_PCM12 | C&K | PCM12SMTR | C221841 | SELECTOR | assembler | MPN_READ_2026-11-13_STOCK_AND_PRICE_UNKNOWN
choc | J7 | SEL1: RUN 1-2 / ROM 2-3 | Button_Switch_SMD:SW_SPDT_PCM12 | C&K | PCM12SMTR | C221841 | SELECTOR | assembler | MPN_READ_2026-11-13_STOCK_AND_PRICE_UNKNOWN
choc | J4 | nice!view SPI LCD | worxboard:PinSocket_1x05_P2.54mm_Vertical_H5.0mm | HJ Tech | 17-0004-002 |  | DISPLAY | customer | UNVERIFIED_NOT_FOR_ORDER
choc | J5 | RGB expansion (3V3 logic) | Connector_JST:JST_SH_SM03B-SRSS-TB_1x03-1MP_P1.00mm_Horizontal | JST | SM03B-SRSS-TB(LF)(SN) | C160403 | DISPLAY | assembler | MPN_READ_2026-11-13_STOCK_AND_PRICE_UNKNOWN
choc | SK101 | CHOC | worxboard:SW_Choc_V1_Hotswap | Kailh | CPG135001S30 | C5333465 | MATRIX | assembler | MPN_READ_2026-11-13_STOCK_AND_PRICE_UNKNOWN
choc | D101 | 1N4148W | Diode_SMD:D_SOD-123 | ST (Semtech), as LCSC lists it | 1N4148W | C81598 | MATRIX | assembler | MPN_READ_2026-11-13_STOCK_AND_PRICE_UNKNOWN
choc | SK102 | CHOC | worxboard:SW_Choc_V1_Hotswap | Kailh | CPG135001S30 | C5333465 | MATRIX | assembler | MPN_READ_2026-11-13_STOCK_AND_PRICE_UNKNOWN
choc | D102 | 1N4148W | Diode_SMD:D_SOD-123 | ST (Semtech), as LCSC lists it | 1N4148W | C81598 | MATRIX | assembler | MPN_READ_2026-11-13_STOCK_AND_PRICE_UNKNOWN
choc | SK103 | CHOC | worxboard:SW_Choc_V1_Hotswap | Kailh | CPG135001S30 | C5333465 | MATRIX | assembler | MPN_READ_2026-11-13_STOCK_AND_PRICE_UNKNOWN
choc | D103 | 1N4148W | Diode_SMD:D_SOD-123 | ST (Semtech), as LCSC lists it | 1N4148W | C81598 | MATRIX | assembler | MPN_READ_2026-11-13_STOCK_AND_PRICE_UNKNOWN
choc | SK104 | CHOC | worxboard:SW_Choc_V1_Hotswap | Kailh | CPG135001S30 | C5333465 | MATRIX | assembler | MPN_READ_2026-11-13_STOCK_AND_PRICE_UNKNOWN
choc | D104 | 1N4148W | Diode_SMD:D_SOD-123 | ST (Semtech), as LCSC lists it | 1N4148W | C81598 | MATRIX | assembler | MPN_READ_2026-11-13_STOCK_AND_PRICE_UNKNOWN
choc | SK105 | CHOC | worxboard:SW_Choc_V1_Hotswap | Kailh | CPG135001S30 | C5333465 | MATRIX | assembler | MPN_READ_2026-11-13_STOCK_AND_PRICE_UNKNOWN
choc | D105 | 1N4148W | Diode_SMD:D_SOD-123 | ST (Semtech), as LCSC lists it | 1N4148W | C81598 | MATRIX | assembler | MPN_READ_2026-11-13_STOCK_AND_PRICE_UNKNOWN
choc | SK106 | CHOC | worxboard:SW_Choc_V1_Hotswap | Kailh | CPG135001S30 | C5333465 | MATRIX | assembler | MPN_READ_2026-11-13_STOCK_AND_PRICE_UNKNOWN
choc | D106 | 1N4148W | Diode_SMD:D_SOD-123 | ST (Semtech), as LCSC lists it | 1N4148W | C81598 | MATRIX | assembler | MPN_READ_2026-11-13_STOCK_AND_PRICE_UNKNOWN
choc | SK107 | CHOC | worxboard:SW_Choc_V1_Hotswap | Kailh | CPG135001S30 | C5333465 | MATRIX | assembler | MPN_READ_2026-11-13_STOCK_AND_PRICE_UNKNOWN
choc | D107 | 1N4148W | Diode_SMD:D_SOD-123 | ST (Semtech), as LCSC lists it | 1N4148W | C81598 | MATRIX | assembler | MPN_READ_2026-11-13_STOCK_AND_PRICE_UNKNOWN
choc | SK108 | CHOC | worxboard:SW_Choc_V1_Hotswap | Kailh | CPG135001S30 | C5333465 | MATRIX | assembler | MPN_READ_2026-11-13_STOCK_AND_PRICE_UNKNOWN
choc | D108 | 1N4148W | Diode_SMD:D_SOD-123 | ST (Semtech), as LCSC lists it | 1N4148W | C81598 | MATRIX | assembler | MPN_READ_2026-11-13_STOCK_AND_PRICE_UNKNOWN
choc | SK109 | CHOC | worxboard:SW_Choc_V1_Hotswap | Kailh | CPG135001S30 | C5333465 | MATRIX | assembler | MPN_READ_2026-11-13_STOCK_AND_PRICE_UNKNOWN
choc | D109 | 1N4148W | Diode_SMD:D_SOD-123 | ST (Semtech), as LCSC lists it | 1N4148W | C81598 | MATRIX | assembler | MPN_READ_2026-11-13_STOCK_AND_PRICE_UNKNOWN
choc | SK110 | CHOC | worxboard:SW_Choc_V1_Hotswap | Kailh | CPG135001S30 | C5333465 | MATRIX | assembler | MPN_READ_2026-11-13_STOCK_AND_PRICE_UNKNOWN
choc | D110 | 1N4148W | Diode_SMD:D_SOD-123 | ST (Semtech), as LCSC lists it | 1N4148W | C81598 | MATRIX | assembler | MPN_READ_2026-11-13_STOCK_AND_PRICE_UNKNOWN
choc | SK111 | CHOC | worxboard:SW_Choc_V1_Hotswap | Kailh | CPG135001S30 | C5333465 | MATRIX | assembler | MPN_READ_2026-11-13_STOCK_AND_PRICE_UNKNOWN
choc | D111 | 1N4148W | Diode_SMD:D_SOD-123 | ST (Semtech), as LCSC lists it | 1N4148W | C81598 | MATRIX | assembler | MPN_READ_2026-11-13_STOCK_AND_PRICE_UNKNOWN
choc | SK112 | CHOC | worxboard:SW_Choc_V1_Hotswap | Kailh | CPG135001S30 | C5333465 | MATRIX | assembler | MPN_READ_2026-11-13_STOCK_AND_PRICE_UNKNOWN
choc | D112 | 1N4148W | Diode_SMD:D_SOD-123 | ST (Semtech), as LCSC lists it | 1N4148W | C81598 | MATRIX | assembler | MPN_READ_2026-11-13_STOCK_AND_PRICE_UNKNOWN
choc | SK113 | CHOC | worxboard:SW_Choc_V1_Hotswap | Kailh | CPG135001S30 | C5333465 | MATRIX | assembler | MPN_READ_2026-11-13_STOCK_AND_PRICE_UNKNOWN
choc | D113 | 1N4148W | Diode_SMD:D_SOD-123 | ST (Semtech), as LCSC lists it | 1N4148W | C81598 | MATRIX | assembler | MPN_READ_2026-11-13_STOCK_AND_PRICE_UNKNOWN
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
choc | SK147 | CHOC | worxboard:SW_Choc_V1_Hotswap | Kailh | CPG135001S30 | C5333465 | MATRIX | assembler | MPN_READ_2026-11-13_STOCK_AND_PRICE_UNKNOWN
choc | D147 | 1N4148W | Diode_SMD:D_SOD-123 | ST (Semtech), as LCSC lists it | 1N4148W | C81598 | MATRIX | assembler | MPN_READ_2026-11-13_STOCK_AND_PRICE_UNKNOWN
choc | SK148 | CHOC | worxboard:SW_Choc_V1_Hotswap | Kailh | CPG135001S30 | C5333465 | MATRIX | assembler | MPN_READ_2026-11-13_STOCK_AND_PRICE_UNKNOWN
choc | D148 | 1N4148W | Diode_SMD:D_SOD-123 | ST (Semtech), as LCSC lists it | 1N4148W | C81598 | MATRIX | assembler | MPN_READ_2026-11-13_STOCK_AND_PRICE_UNKNOWN
