w0rxbend/worxboard-ergo/cad/exports/choc/assembly.step

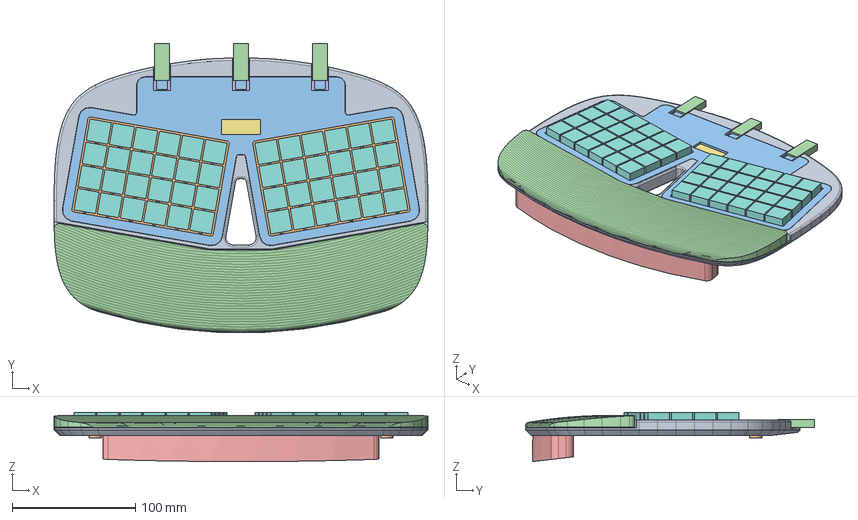
[picture p15: CAD file, 2026-11-14]
cad/exports/choc/assembly.step
303.0 x 234.2 x 39.9 mm
chassis
plate
top_cover
palm_rest
riser
pcb_envelope
lcd_envelope
keycap_envelopes
switch_envelopes
pad_envelopes
usb_receptacle_envelopes
usb_plug_envelopes
