w0rxbend/worxboard-ergo/cad/exports/mx/assembly.step

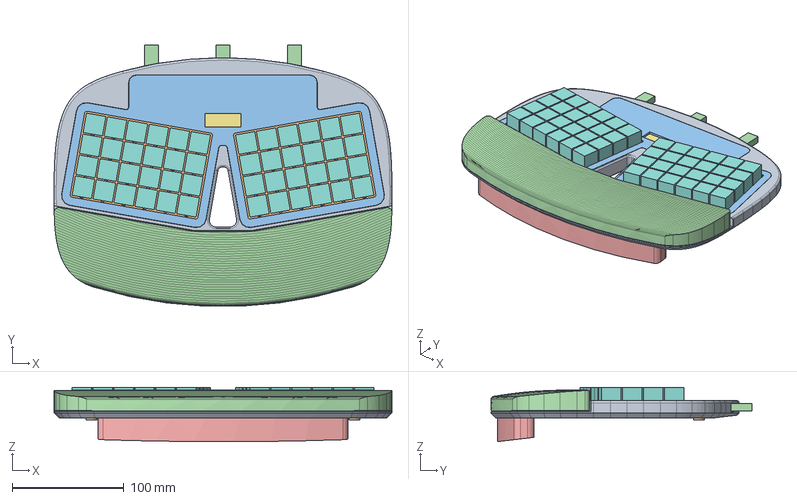
[picture p16: CAD file, 2026-11-14]
cad/exports/mx/assembly.step
303.0 x 234.2 x 48.7 mm
chassis
plate
top_cover
palm_rest
riser
pcb_envelope
lcd_envelope
keycap_envelopes
switch_envelopes
pad_envelopes
usb_receptacle_envelopes
usb_plug_envelopes
