w0rxbend/worxboard-ergo/cad/exports/choc/top_cover_right.step

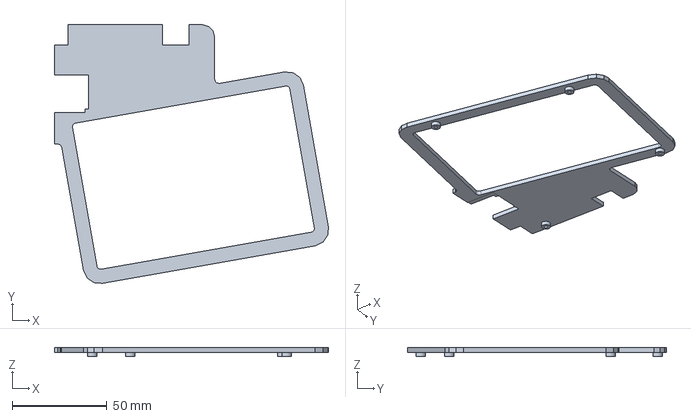
[picture p17: CAD file, 2026-11-14]
cad/exports/choc/top_cover_right.step
144.4 x 136.4 x 4.70 mm
