w0rxbend/worxboard-ergo/cad/exports/mx/chassis.step

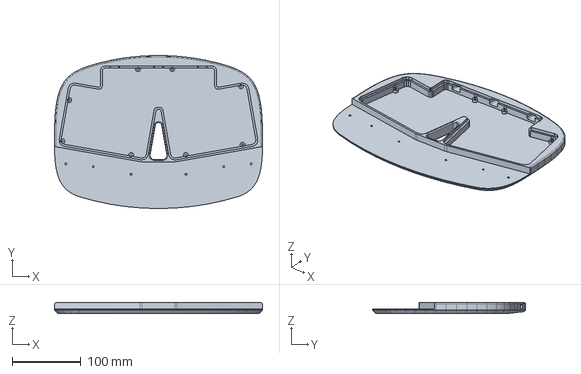
[picture p18: CAD file, 2026-11-14]
cad/exports/mx/chassis.step
303.0 x 223.0 x 15.5 mm
