w0rxbend/worxboard-ergo/cad/exports/choc/plate.step

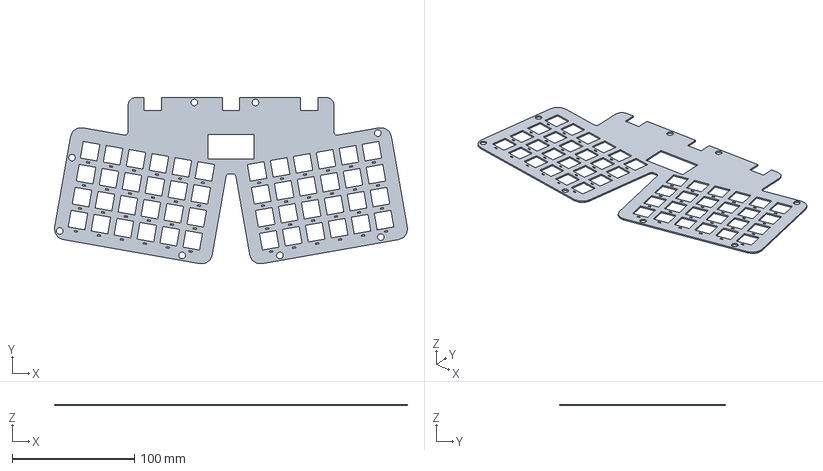
[picture p19: CAD file, 2026-11-14]
cad/exports/choc/plate.step
288.6 x 136.1 x 1.20 mm
