w0rxbend/worxboard-ergo/cad/exports/mx/chassis_right.step

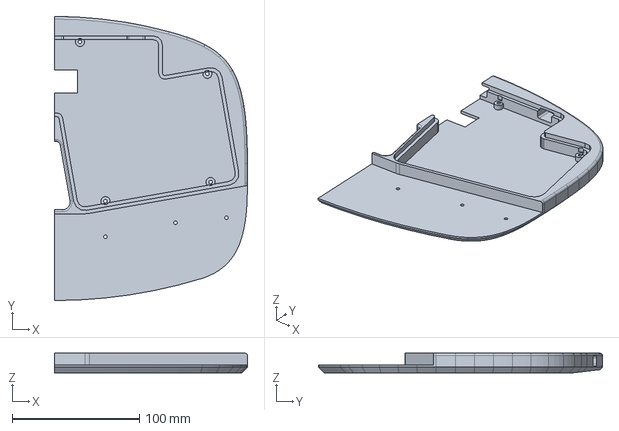
[picture p20: CAD file, 2026-11-14]
cad/exports/mx/chassis_right.step
151.5 x 223.0 x 15.5 mm
