w0rxbend/worxboard-ergo/cad/exports/choc/top_cover.step

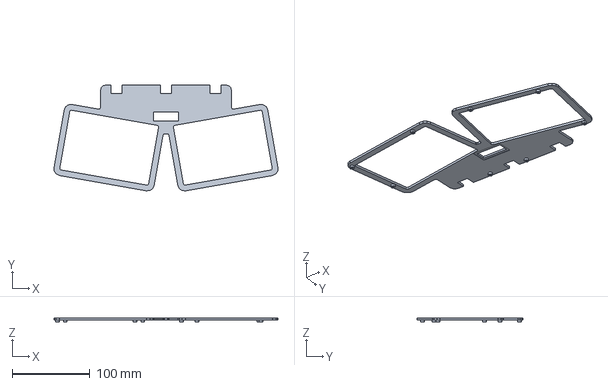
[picture p21: CAD file, 2026-11-14]
cad/exports/choc/top_cover.step
288.9 x 136.4 x 4.70 mm
