w0rxbend/worxboard-ergo/cad/exports/mx/plate_left.step

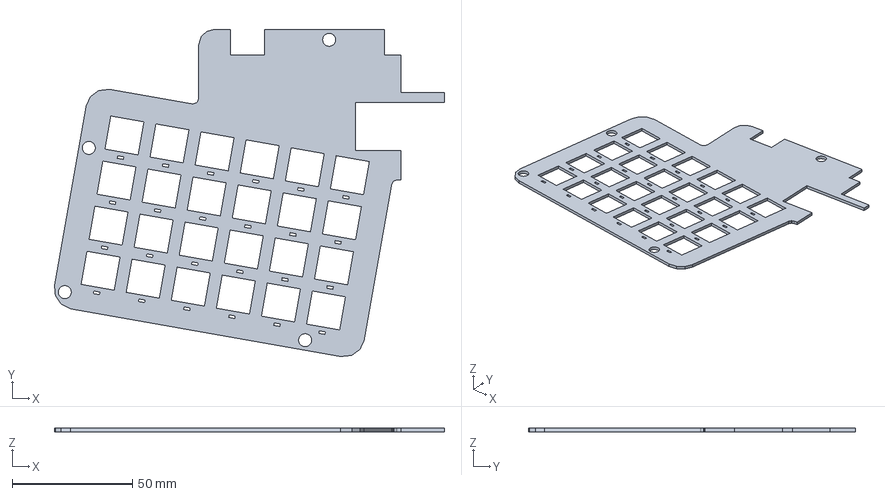
[picture p22: CAD file, 2026-11-14]
cad/exports/mx/plate_left.step
162.3 x 136.1 x 1.50 mm
