w0rxbend/worxboard-ergo/cad/exports/choc/riser.step

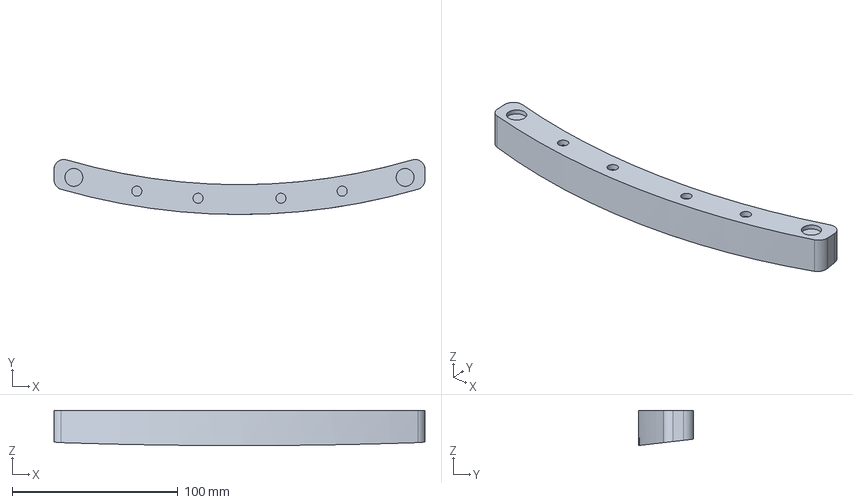
[picture p23: CAD file, 2026-11-14]
cad/exports/choc/riser.step
224.0 x 33.2 x 21.2 mm
