w0rxbend/worxboard-ergo/cad/exports/mx/plate_right.step

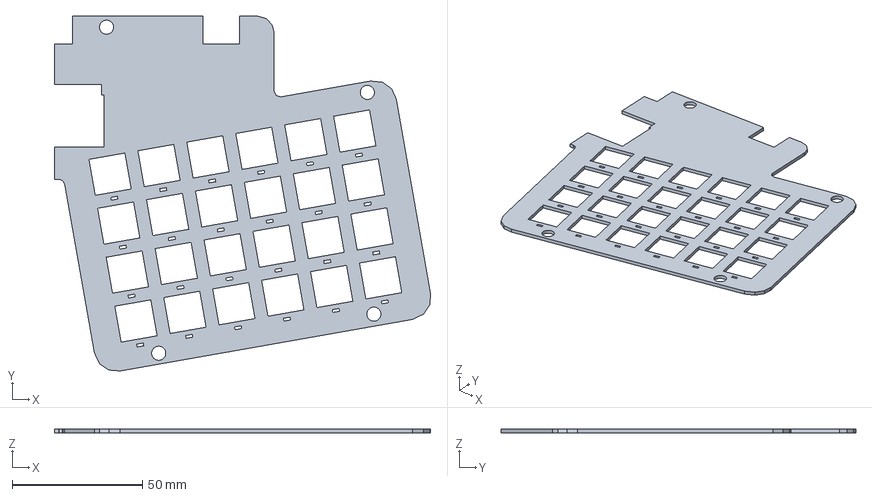
[picture p24: CAD file, 2026-11-14]
cad/exports/mx/plate_right.step
144.3 x 136.1 x 1.50 mm
