w0rxbend/worxboard-ergo/cad/exports/mx/palm_rest.step

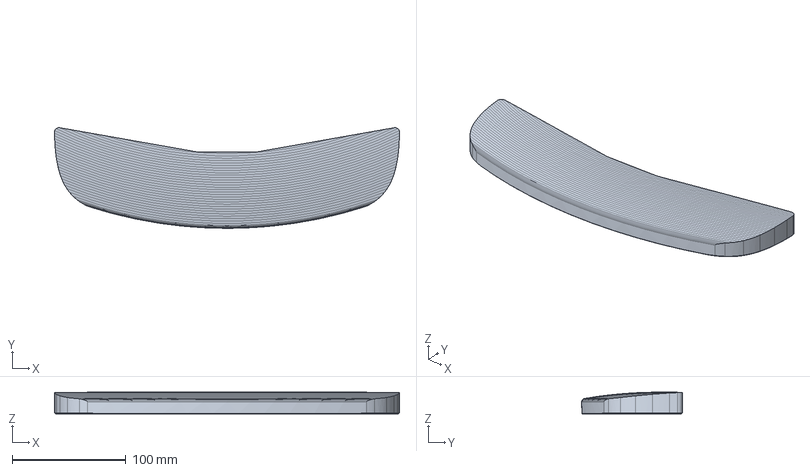
[picture p25: CAD file, 2026-11-14]
cad/exports/mx/palm_rest.step
302.7 x 88.3 x 19.0 mm
