w0rxbend/worxboard-ergo/cad/exports/choc/chassis_right.step

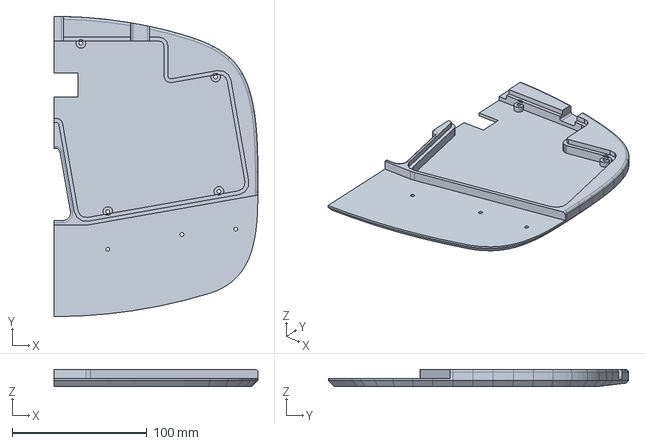
[picture p26: CAD file, 2026-11-14]
cad/exports/choc/chassis_right.step
151.5 x 223.0 x 12.7 mm
