w0rxbend/worxboard-ergo/cad/exports/mx/plate.step

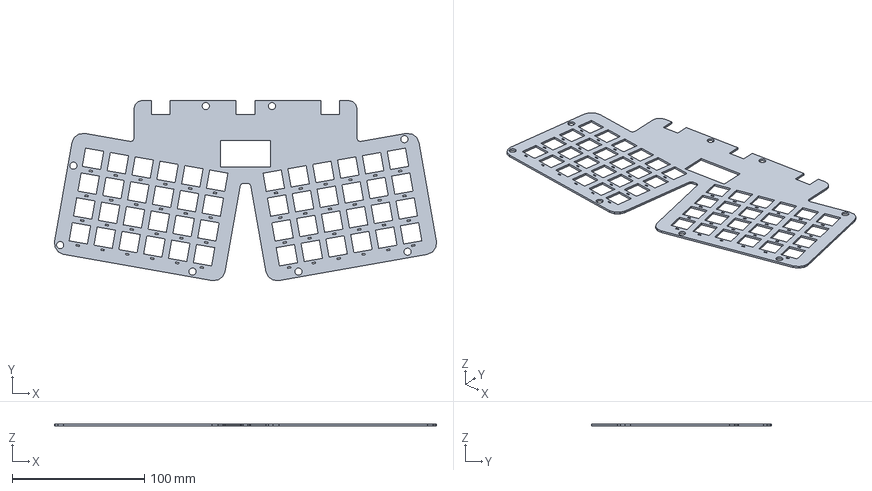
[picture p27: CAD file, 2026-11-14]
cad/exports/mx/plate.step
288.6 x 136.1 x 1.50 mm
