w0rxbend/worxboard-ergo/cad/exports/choc/plate_right.step

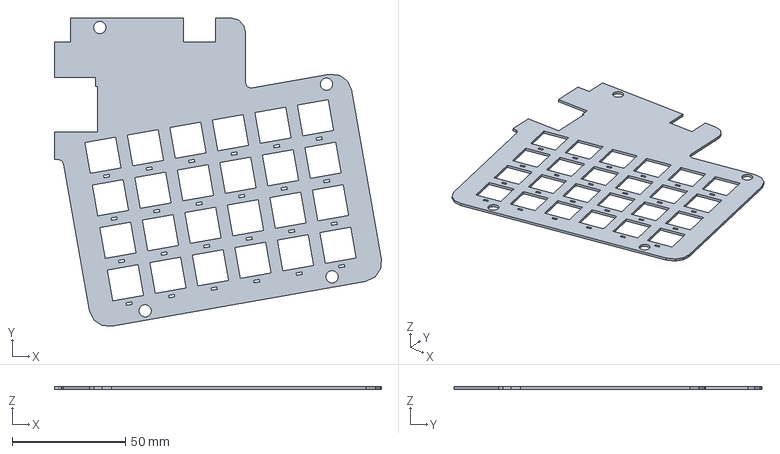
[picture p28: CAD file, 2026-11-14]
cad/exports/choc/plate_right.step
144.3 x 136.1 x 1.20 mm
