w0rxbend/worxboard-ergo/cad/exports/mx/worxboard-ergo-mx.FCStd

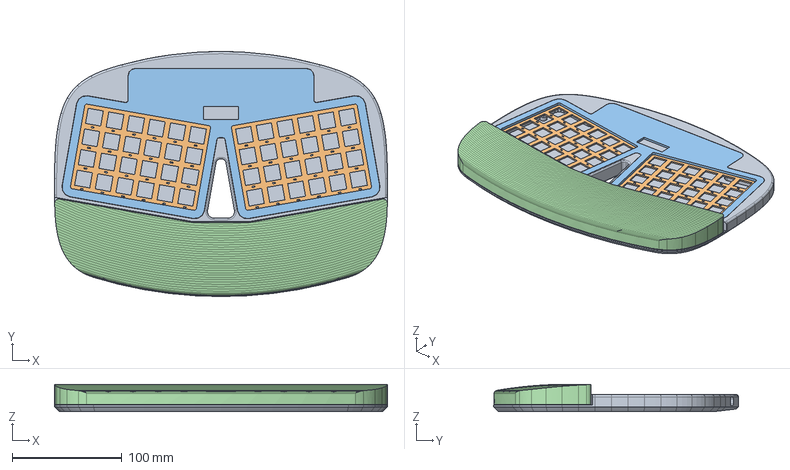
[picture p29: CAD file, 2026-11-14]
cad/exports/mx/worxboard-ergo-mx.FCStd
303.0 x 223.0 x 25.0 mm
chassis
plate
top_cover
palm_rest
