w0rxbend/worxboard-ergo/cad/exports/choc/plate_left.step

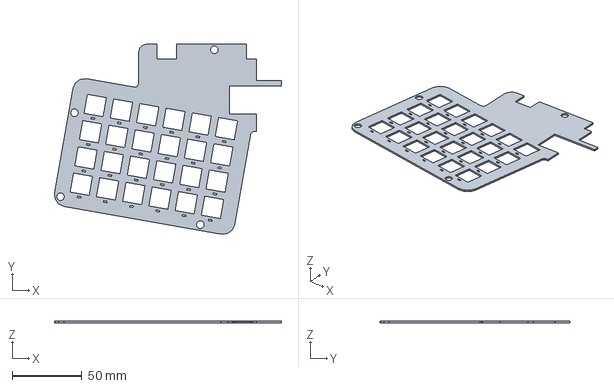
[picture p30: CAD file, 2026-11-14]
cad/exports/choc/plate_left.step
162.3 x 136.1 x 1.20 mm
