w0rxbend/worxboard-ergo/cad/exports/mx/palm_rest_left.step

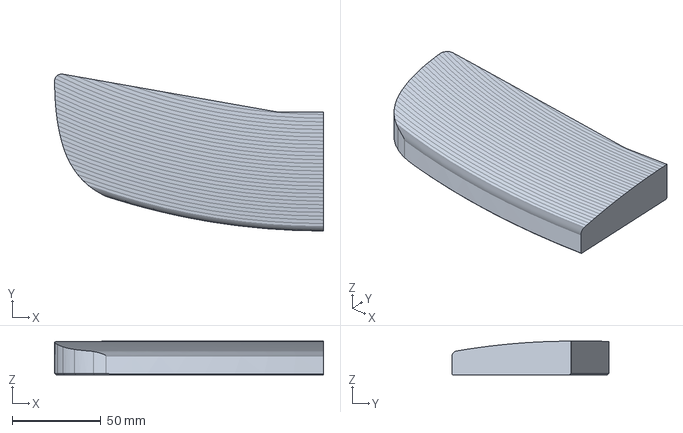
[picture p31: CAD file, 2026-11-14]
cad/exports/mx/palm_rest_left.step
151.4 x 88.3 x 19.0 mm
