w0rxbend/worxboard-ergo/cad/exports/choc/chassis.step

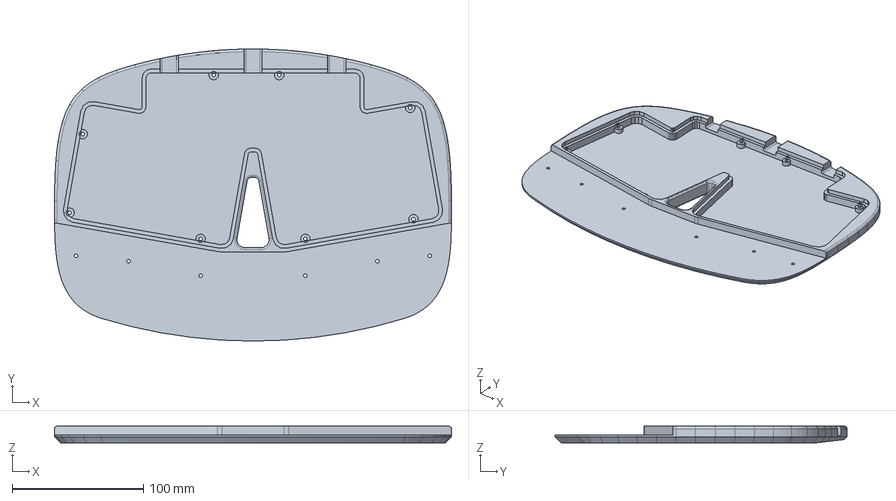
[picture p32: CAD file, 2026-11-14]
cad/exports/choc/chassis.step
303.0 x 223.0 x 12.7 mm
