w0rxbend/worxboard-ergo/cad/exports/choc/palm_rest_left.step

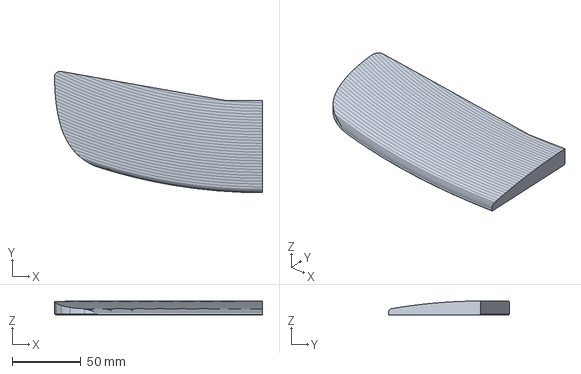
[picture p33: CAD file, 2026-11-14]
cad/exports/choc/palm_rest_left.step
151.4 x 88.3 x 10.2 mm
