w0rxbend/worxboard-ergo/cad/exports/mx/top_cover.step

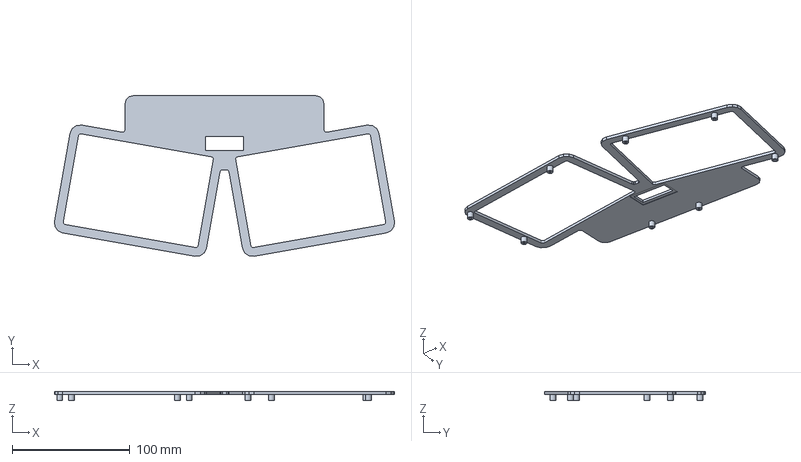
[picture p34: CAD file, 2026-11-14]
cad/exports/mx/top_cover.step
288.9 x 136.4 x 7.50 mm
