w0rxbend/worxboard-ergo/cad/exports/choc/palm_rest.step

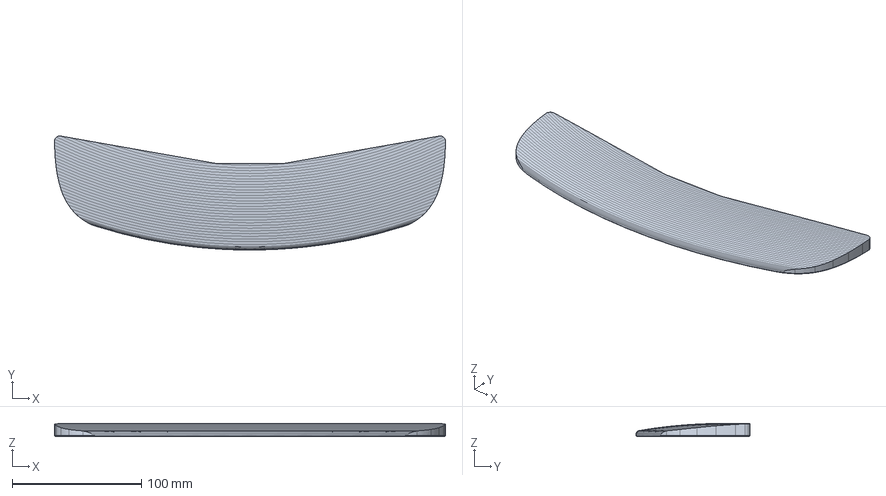
[picture p35: CAD file, 2026-11-14]
cad/exports/choc/palm_rest.step
302.7 x 88.3 x 10.2 mm
