w0rxbend/worxboard-ergo/cad/exports/mx/chassis_left.step

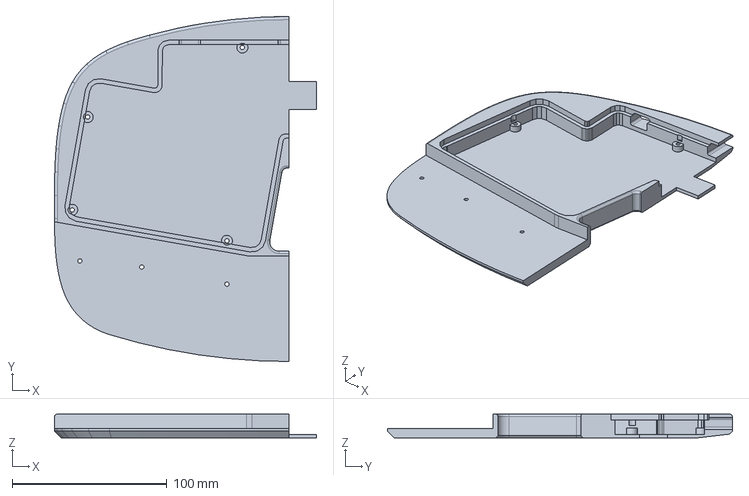
[picture p36: CAD file, 2026-11-14]
cad/exports/mx/chassis_left.step
169.5 x 223.0 x 15.5 mm
