w0rxbend/worxboard-ergo/cad/exports/choc/chassis_left.step

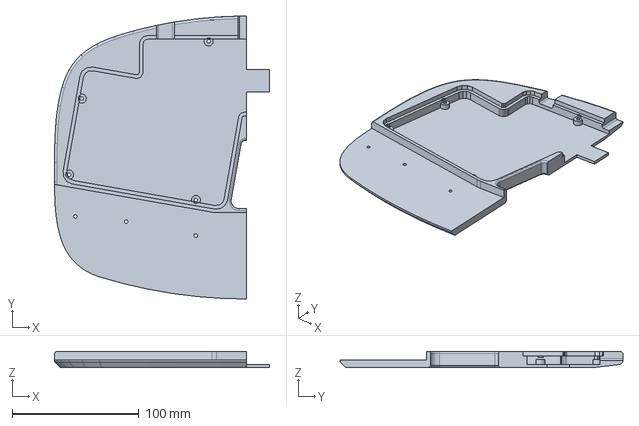
[picture p37: CAD file, 2026-11-14]
cad/exports/choc/chassis_left.step
169.5 x 223.0 x 12.7 mm
