w0rxbend/worxboard-ergo/cad/exports/mx/top_cover_right.step

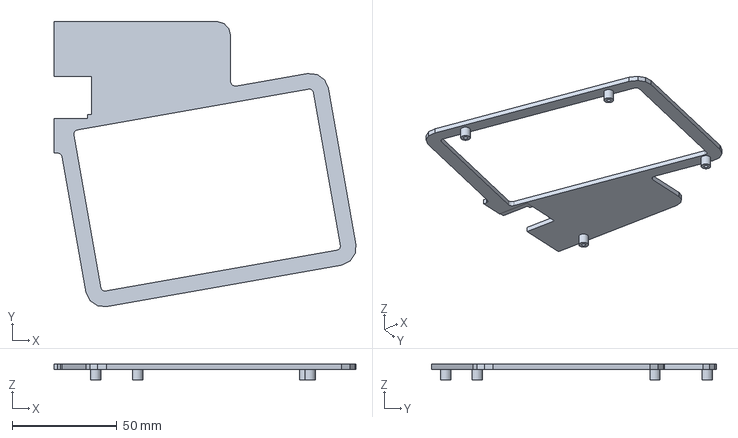
[picture p38: CAD file, 2026-11-14]
cad/exports/mx/top_cover_right.step
144.4 x 136.4 x 7.50 mm
