w0rxbend/worxboard-ergo/cad/exports/choc/top_cover_left.step

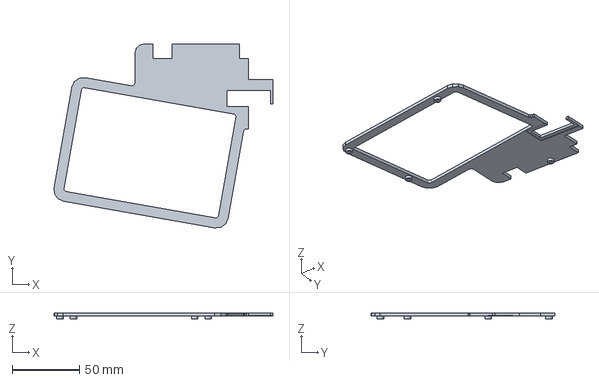
[picture p39: CAD file, 2026-11-14]
cad/exports/choc/top_cover_left.step
162.4 x 136.4 x 4.70 mm
