w0rxbend/worxboard-ergo/cad/exports/mx/top_cover_left.step

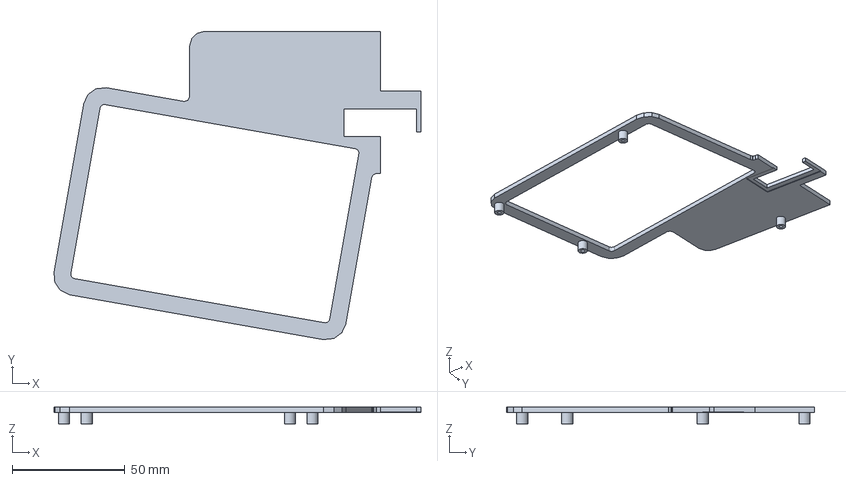
[picture p40: CAD file, 2026-11-14]
cad/exports/mx/top_cover_left.step
162.4 x 136.4 x 7.50 mm
