w0rxbend/worxboard-ergo/cad/exports/choc/worxboard-ergo-choc.FCStd

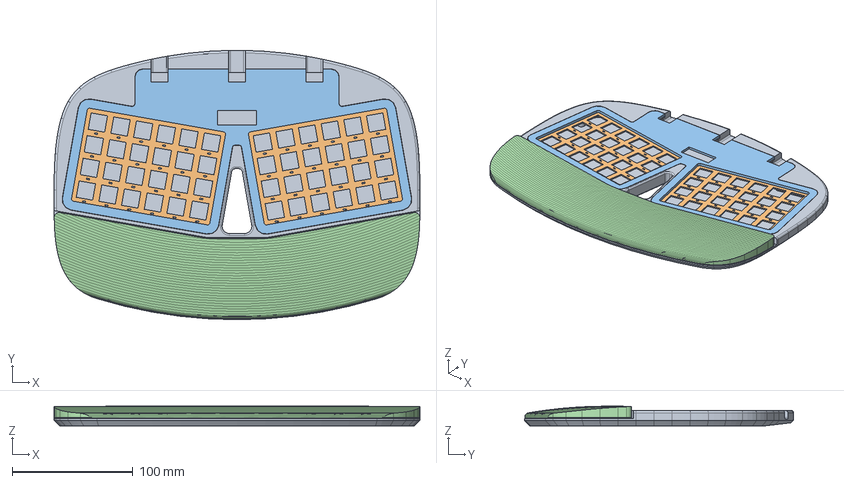
[picture p41: CAD file, 2026-11-14]
cad/exports/choc/worxboard-ergo-choc.FCStd
303.0 x 223.0 x 16.2 mm
chassis
plate
top_cover
palm_rest
