w0rxbend/worxboard-ergo/(list of files, cad)

Other CAD files:
cad/exports/choc/palm_rest_right.step
cad/exports/mx/riser.step
cad/exports/mx/palm_rest_right.step
cad/exports/choc/chassis.3mf
cad/exports/choc/chassis.stl
cad/exports/choc/chassis_left.3mf
cad/exports/choc/chassis_left.stl
cad/exports/choc/chassis_right.3mf
cad/exports/choc/chassis_right.stl
cad/exports/choc/palm_rest.3mf
cad/exports/choc/palm_rest.stl
cad/exports/choc/palm_rest_left.3mf
cad/exports/choc/palm_rest_left.stl
cad/exports/choc/palm_rest_right.3mf
cad/exports/choc/palm_rest_right.stl
cad/exports/choc/plate.3mf
cad/exports/choc/plate.stl
cad/exports/choc/plate_left.3mf
cad/exports/choc/plate_left.stl
cad/exports/choc/plate_right.3mf
cad/exports/choc/plate_right.stl
cad/exports/choc/riser.3mf
cad/exports/choc/riser.stl
cad/exports/choc/top_cover.3mf
cad/exports/choc/top_cover.stl
cad/exports/choc/top_cover_left.3mf
cad/exports/choc/top_cover_left.stl
cad/exports/choc/top_cover_right.3mf
cad/exports/choc/top_cover_right.stl
cad/exports/mx/chassis.3mf
cad/exports/mx/chassis.stl
cad/exports/mx/chassis_left.3mf
cad/exports/mx/chassis_left.stl
cad/exports/mx/chassis_right.3mf
cad/exports/mx/chassis_right.stl
cad/exports/mx/palm_rest.3mf
cad/exports/mx/palm_rest.stl
cad/exports/mx/palm_rest_left.3mf
cad/exports/mx/palm_rest_left.stl
cad/exports/mx/palm_rest_right.3mf
cad/exports/mx/palm_rest_right.stl
cad/exports/mx/plate.3mf
cad/exports/mx/plate.stl
cad/exports/mx/plate_left.3mf
cad/exports/mx/plate_left.stl
cad/exports/mx/plate_right.3mf
cad/exports/mx/plate_right.stl
cad/exports/mx/riser.3mf
cad/exports/mx/riser.stl
cad/exports/mx/top_cover.3mf
cad/exports/mx/top_cover.stl
cad/exports/mx/top_cover_left.3mf
cad/exports/mx/top_cover_left.stl
cad/exports/mx/top_cover_right.3mf
cad/exports/mx/top_cover_right.stl
