w0rxbend/worxboard-ergo/cad/exports/laser/chassis-underside.pdf

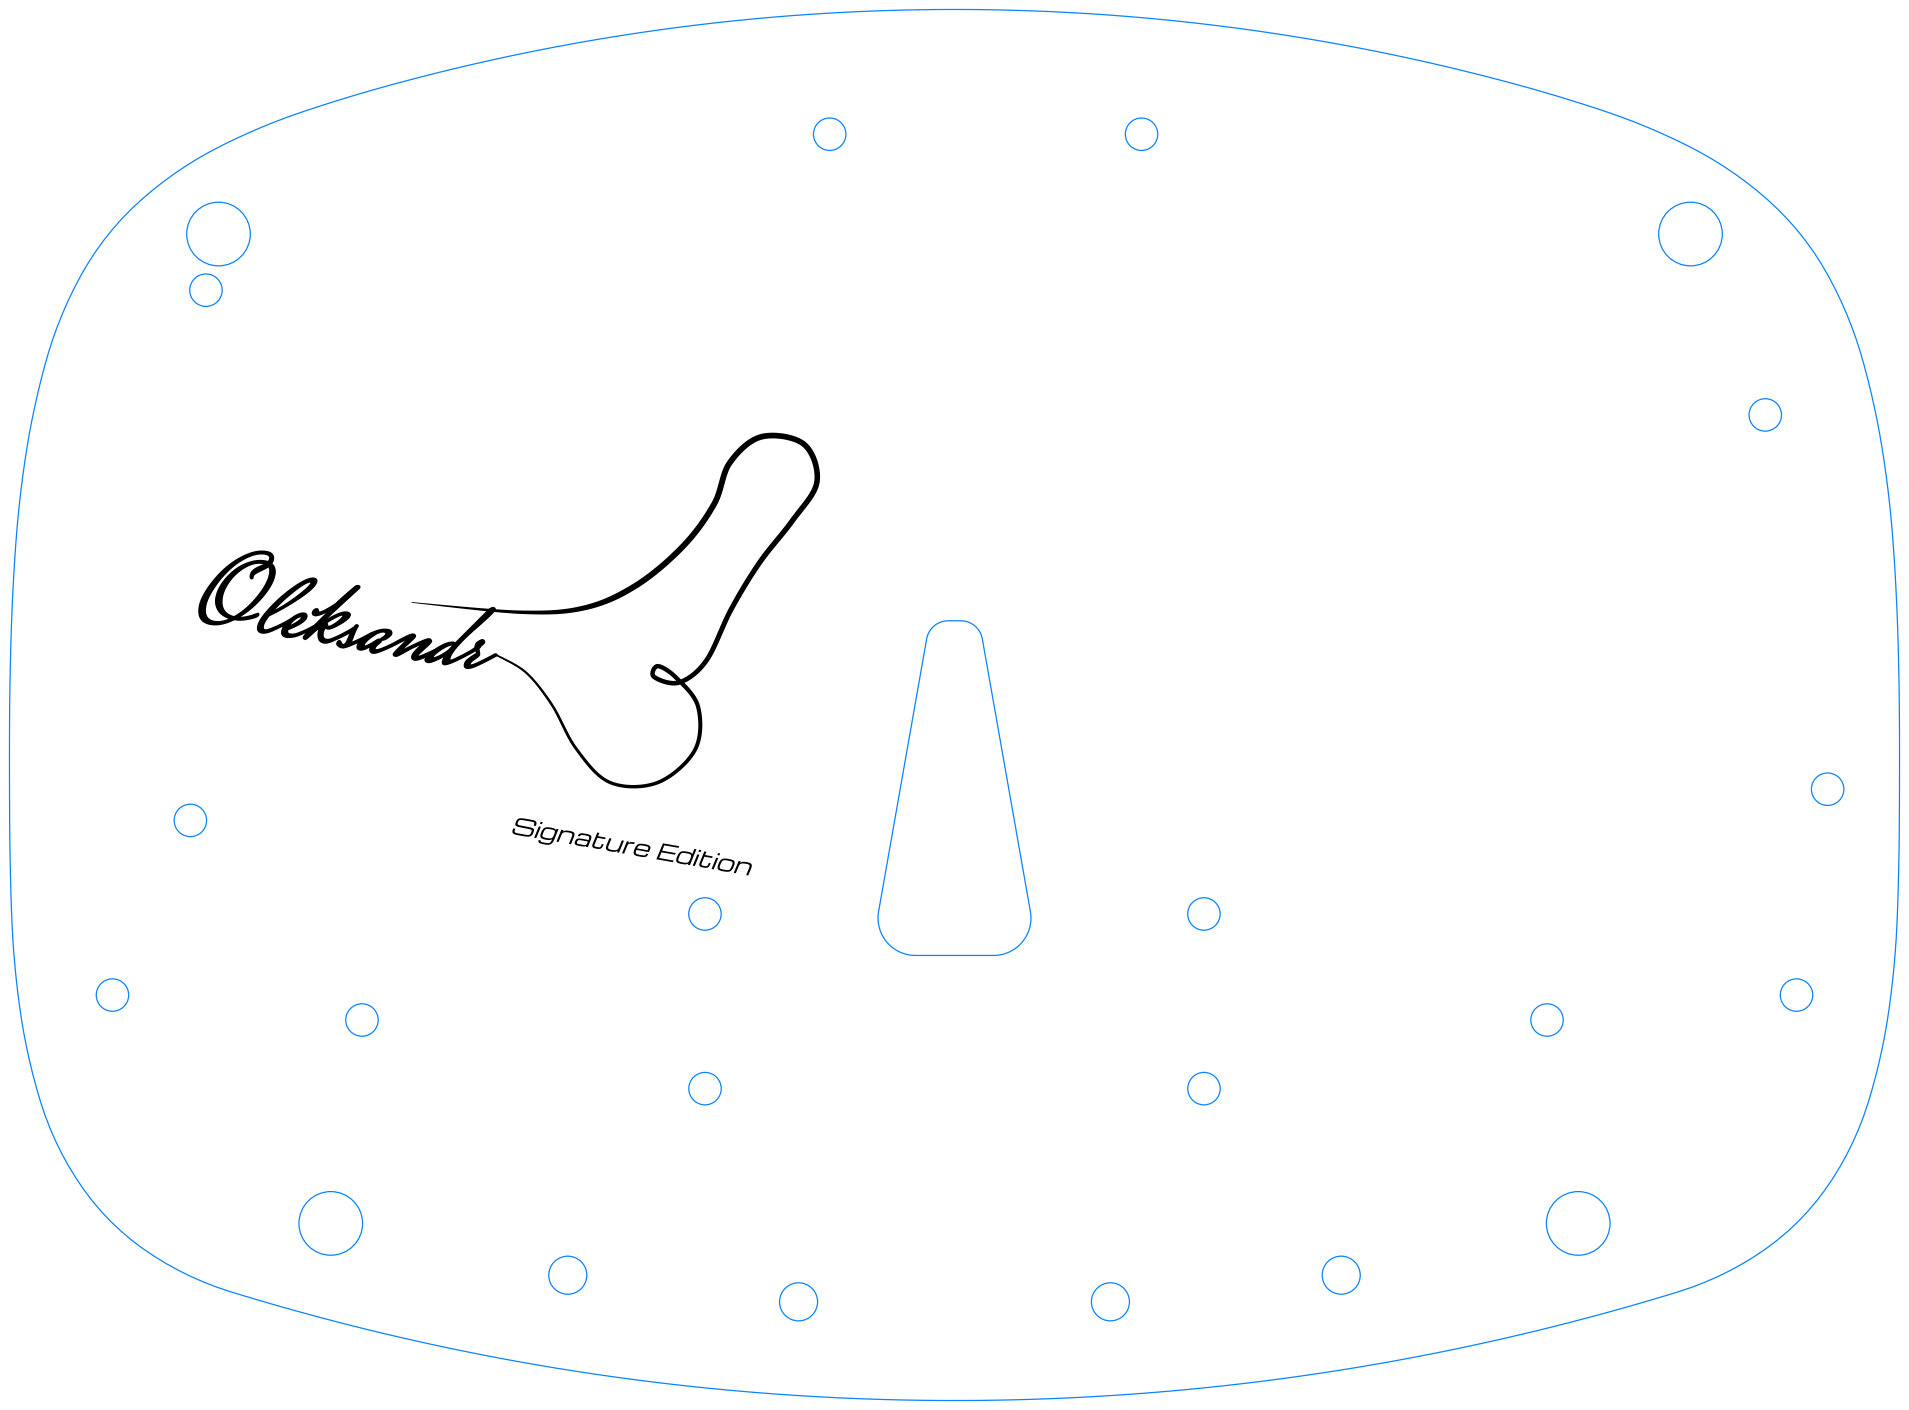
[picture p42: page 1]
