w0rxbend/worxboard-ergo/pcb/mx/worxboard-ergo-mx.kicad_pcb

## KiCad design pcb/mx/worxboard-ergo-mx.kicad_pcb (2026-11-14)

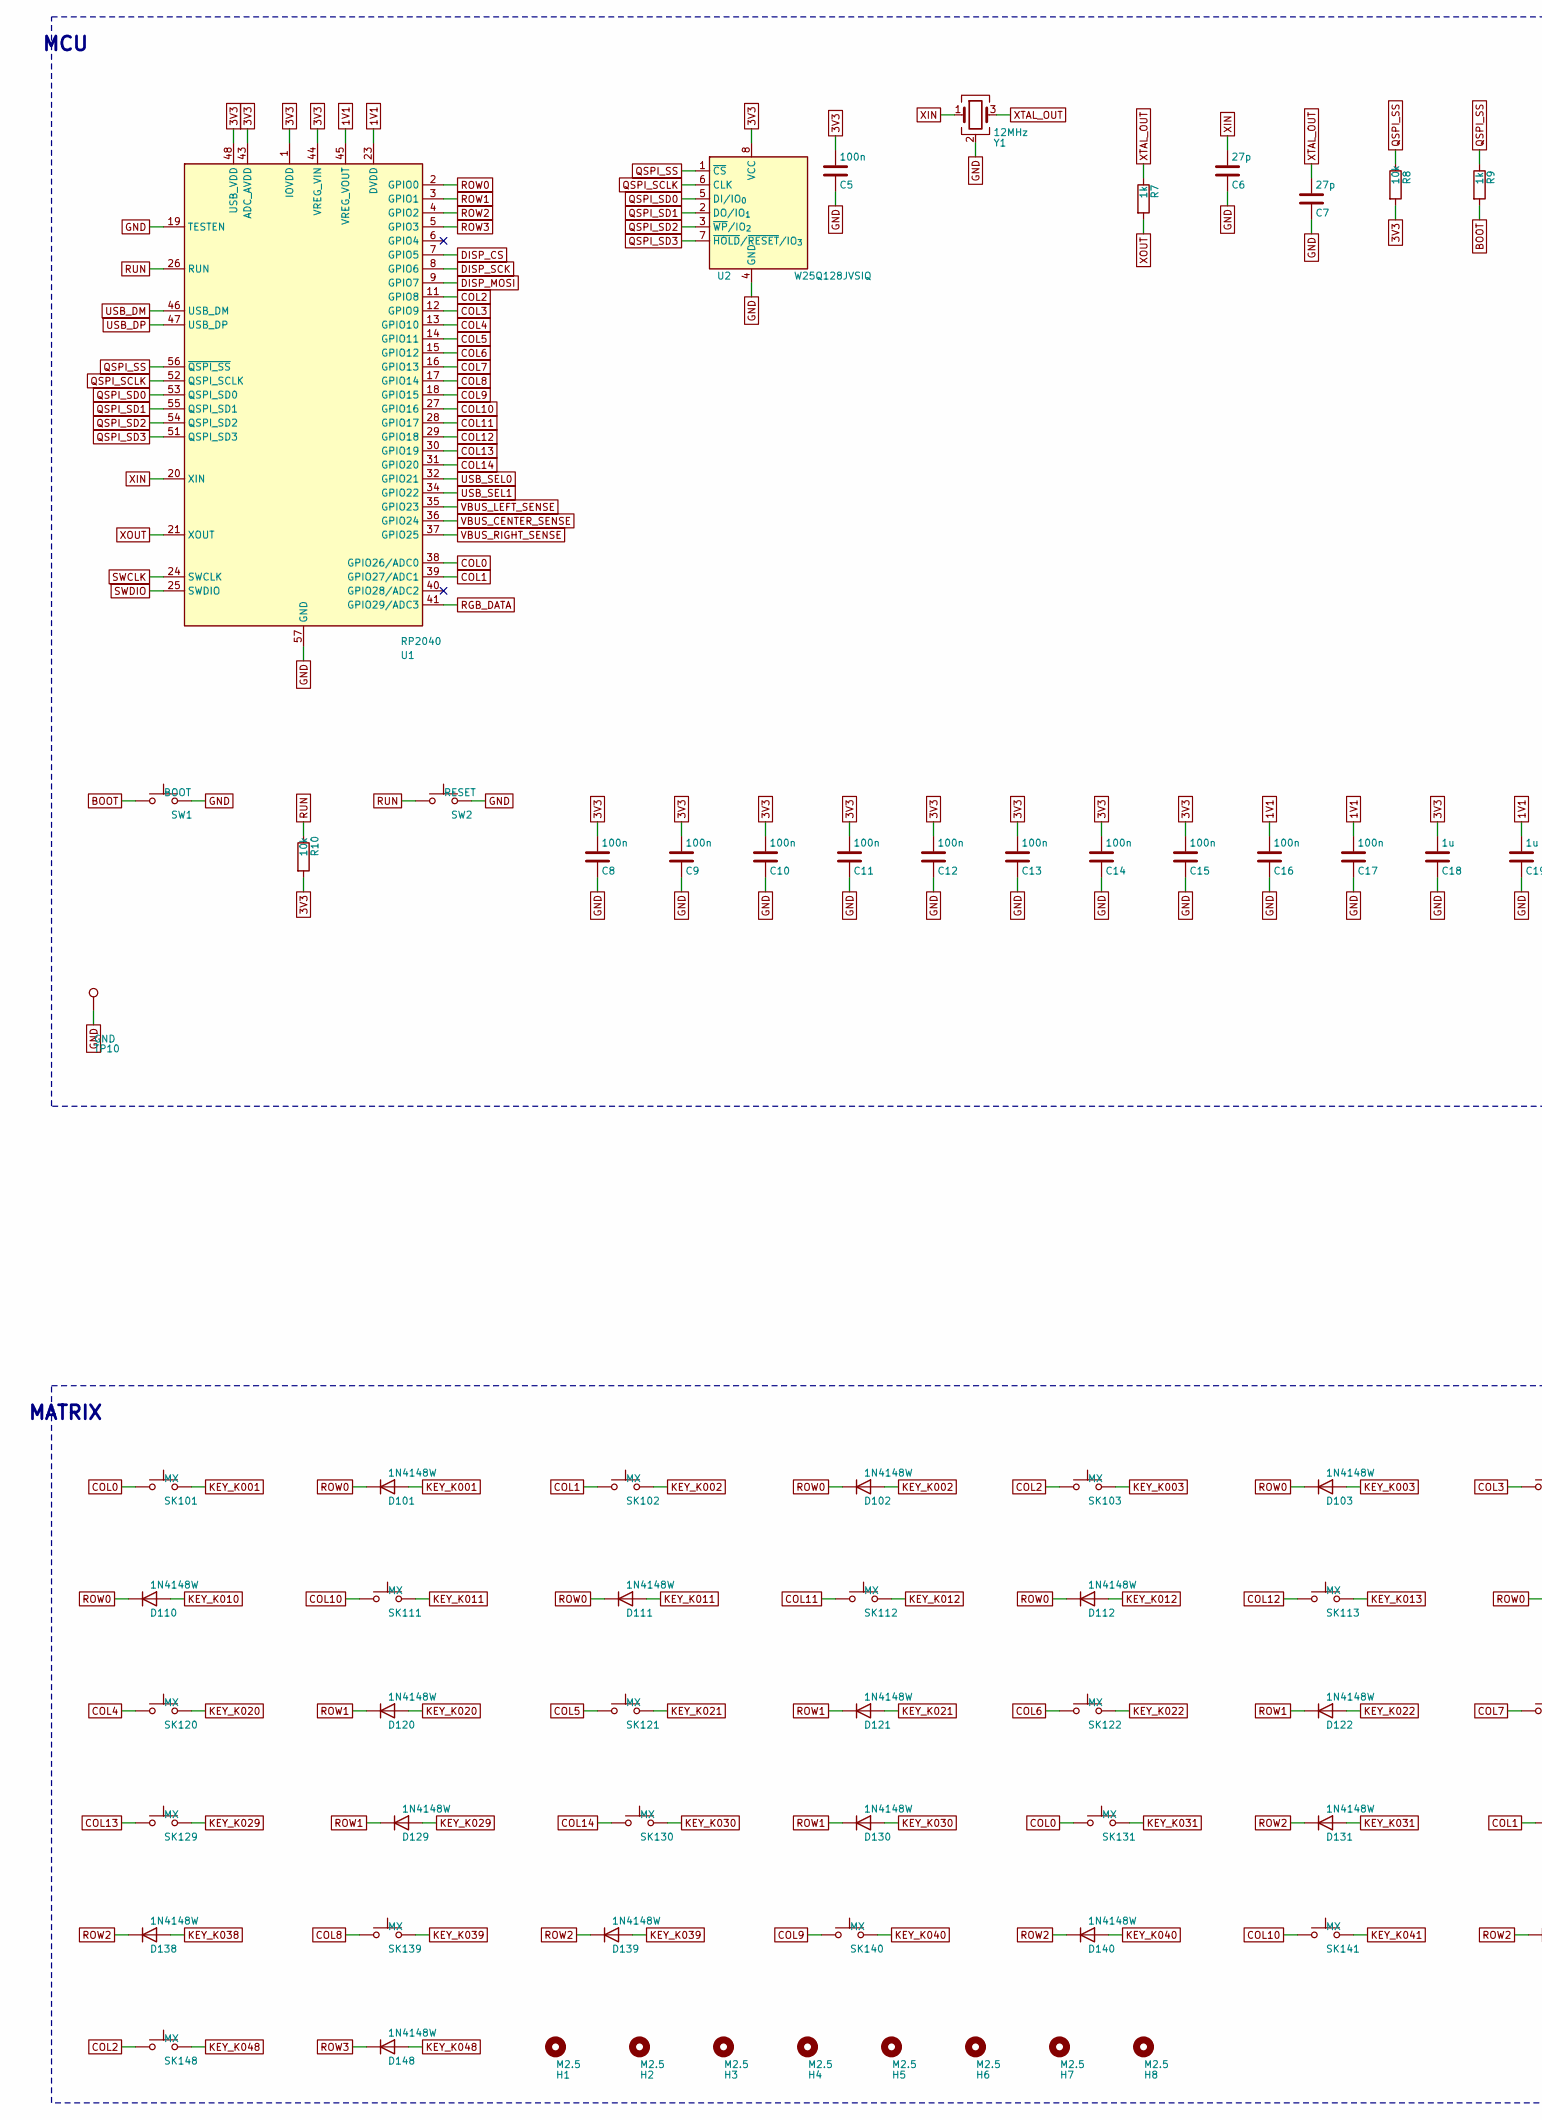
[picture p43: schematic worxboard-ergo-mx.kicad_sch, worxboard ergo mx A0 UNROUTED, part in row 1, column 1]

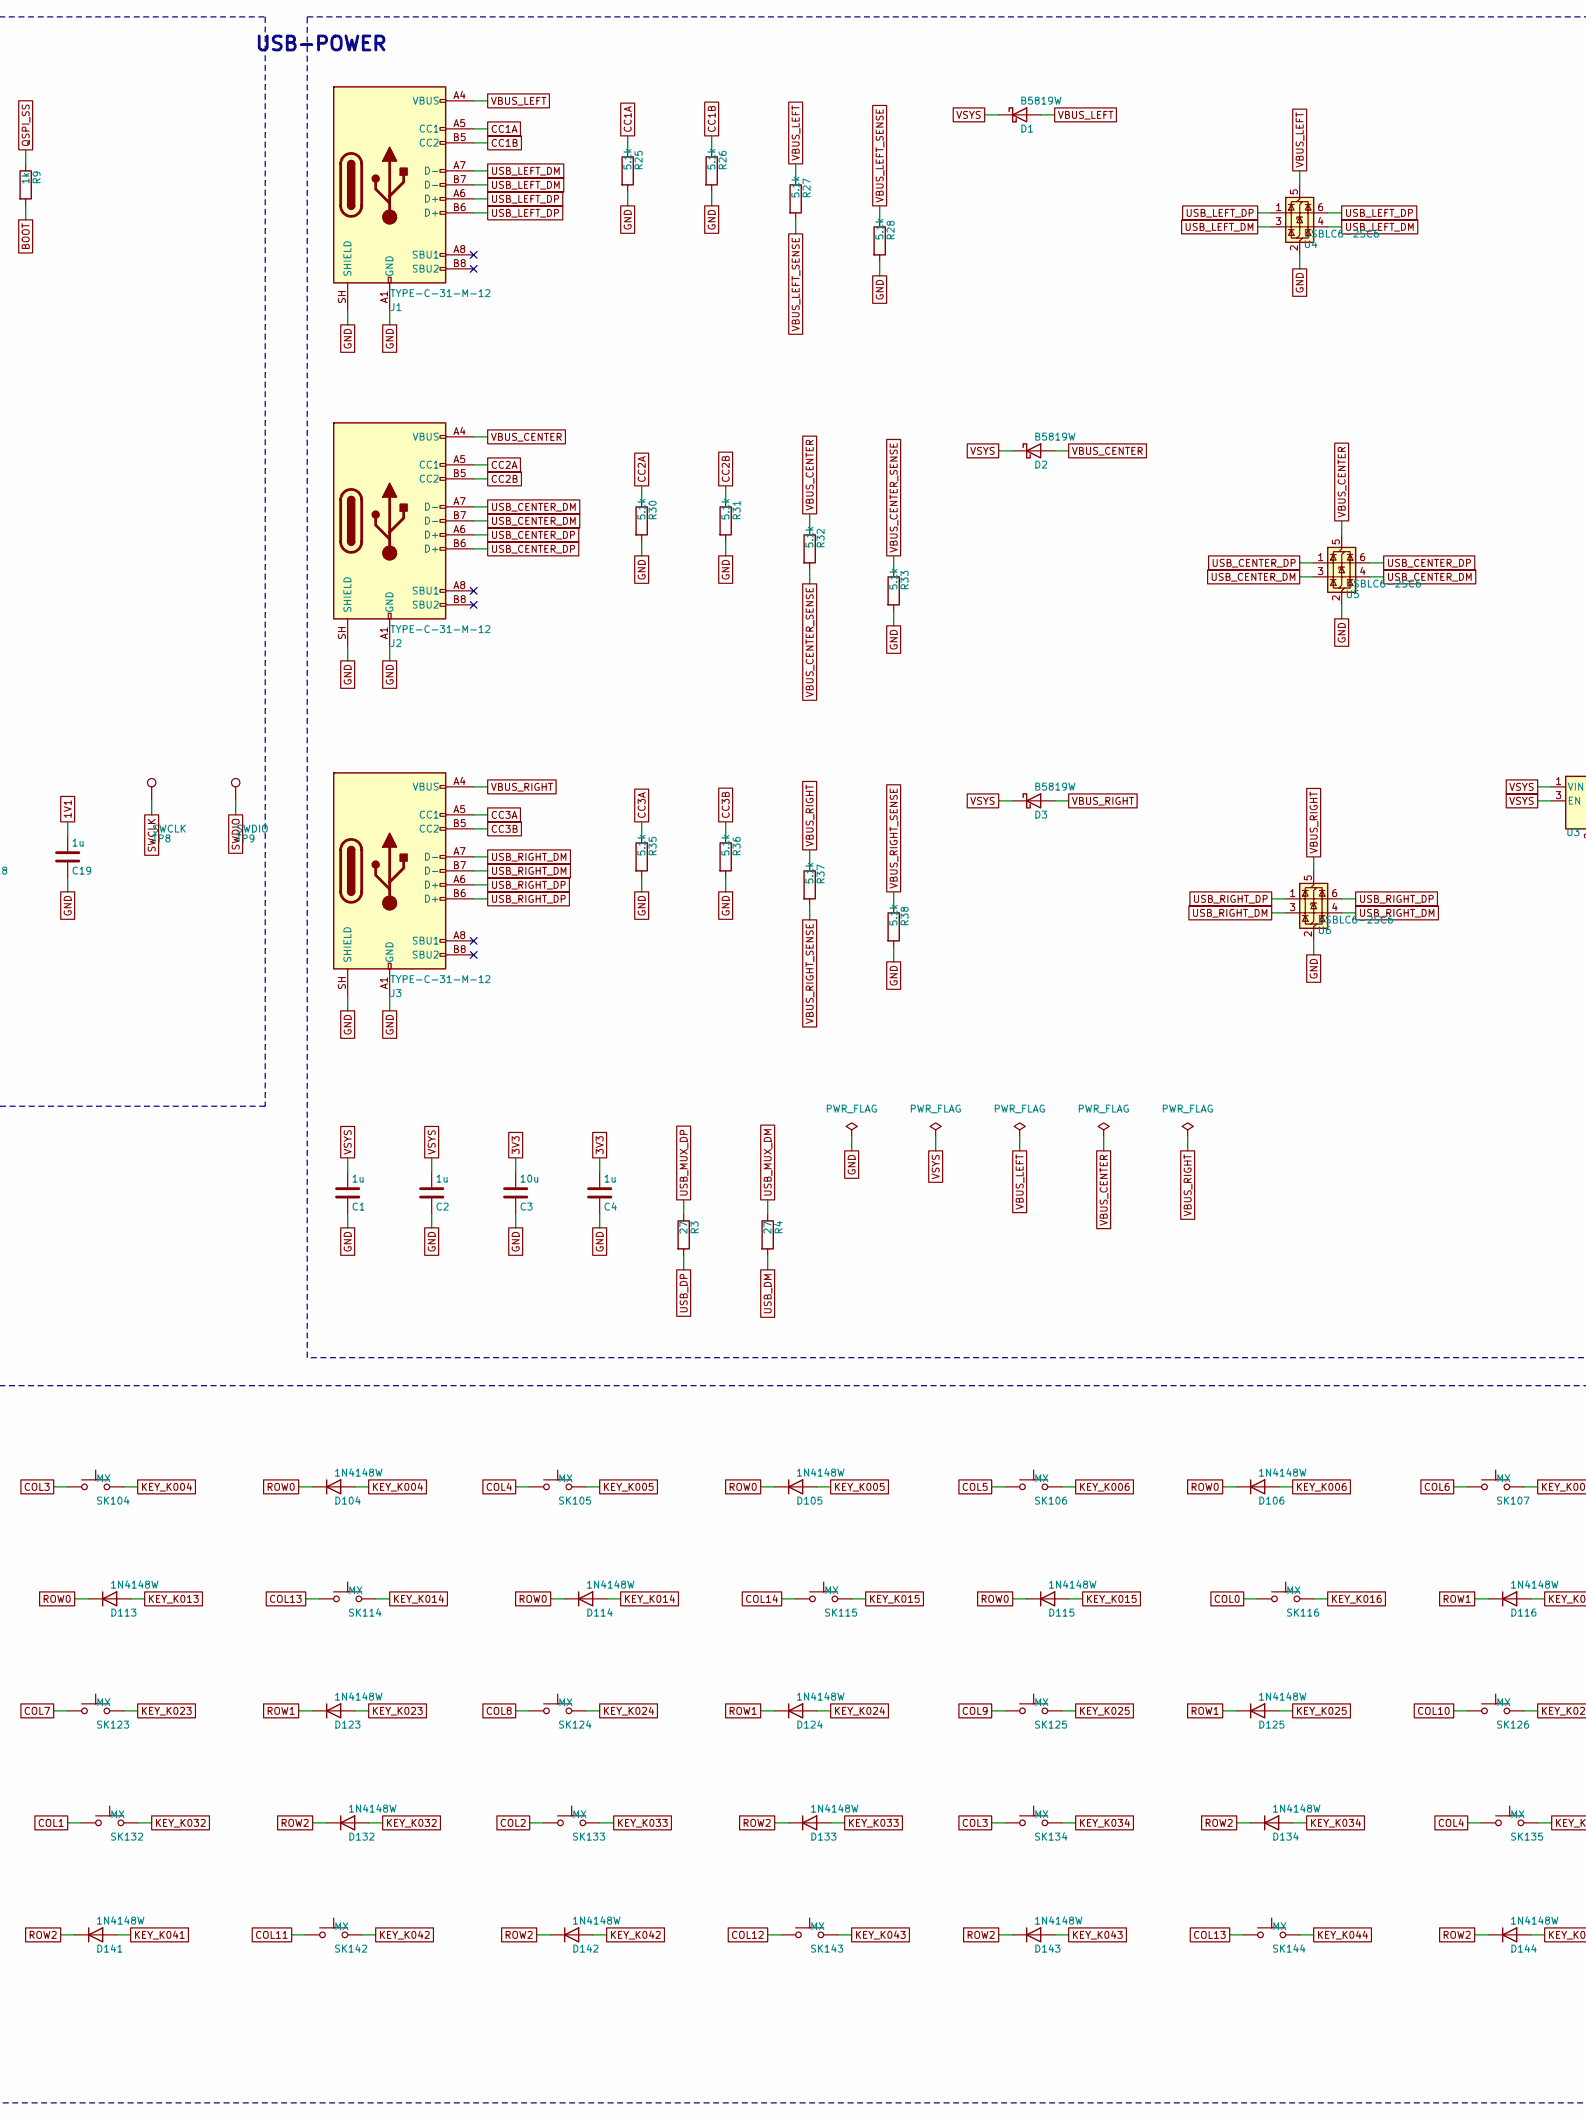
[picture p44: schematic worxboard-ergo-mx.kicad_sch, worxboard ergo mx A0 UNROUTED, part in row 1, column 2]

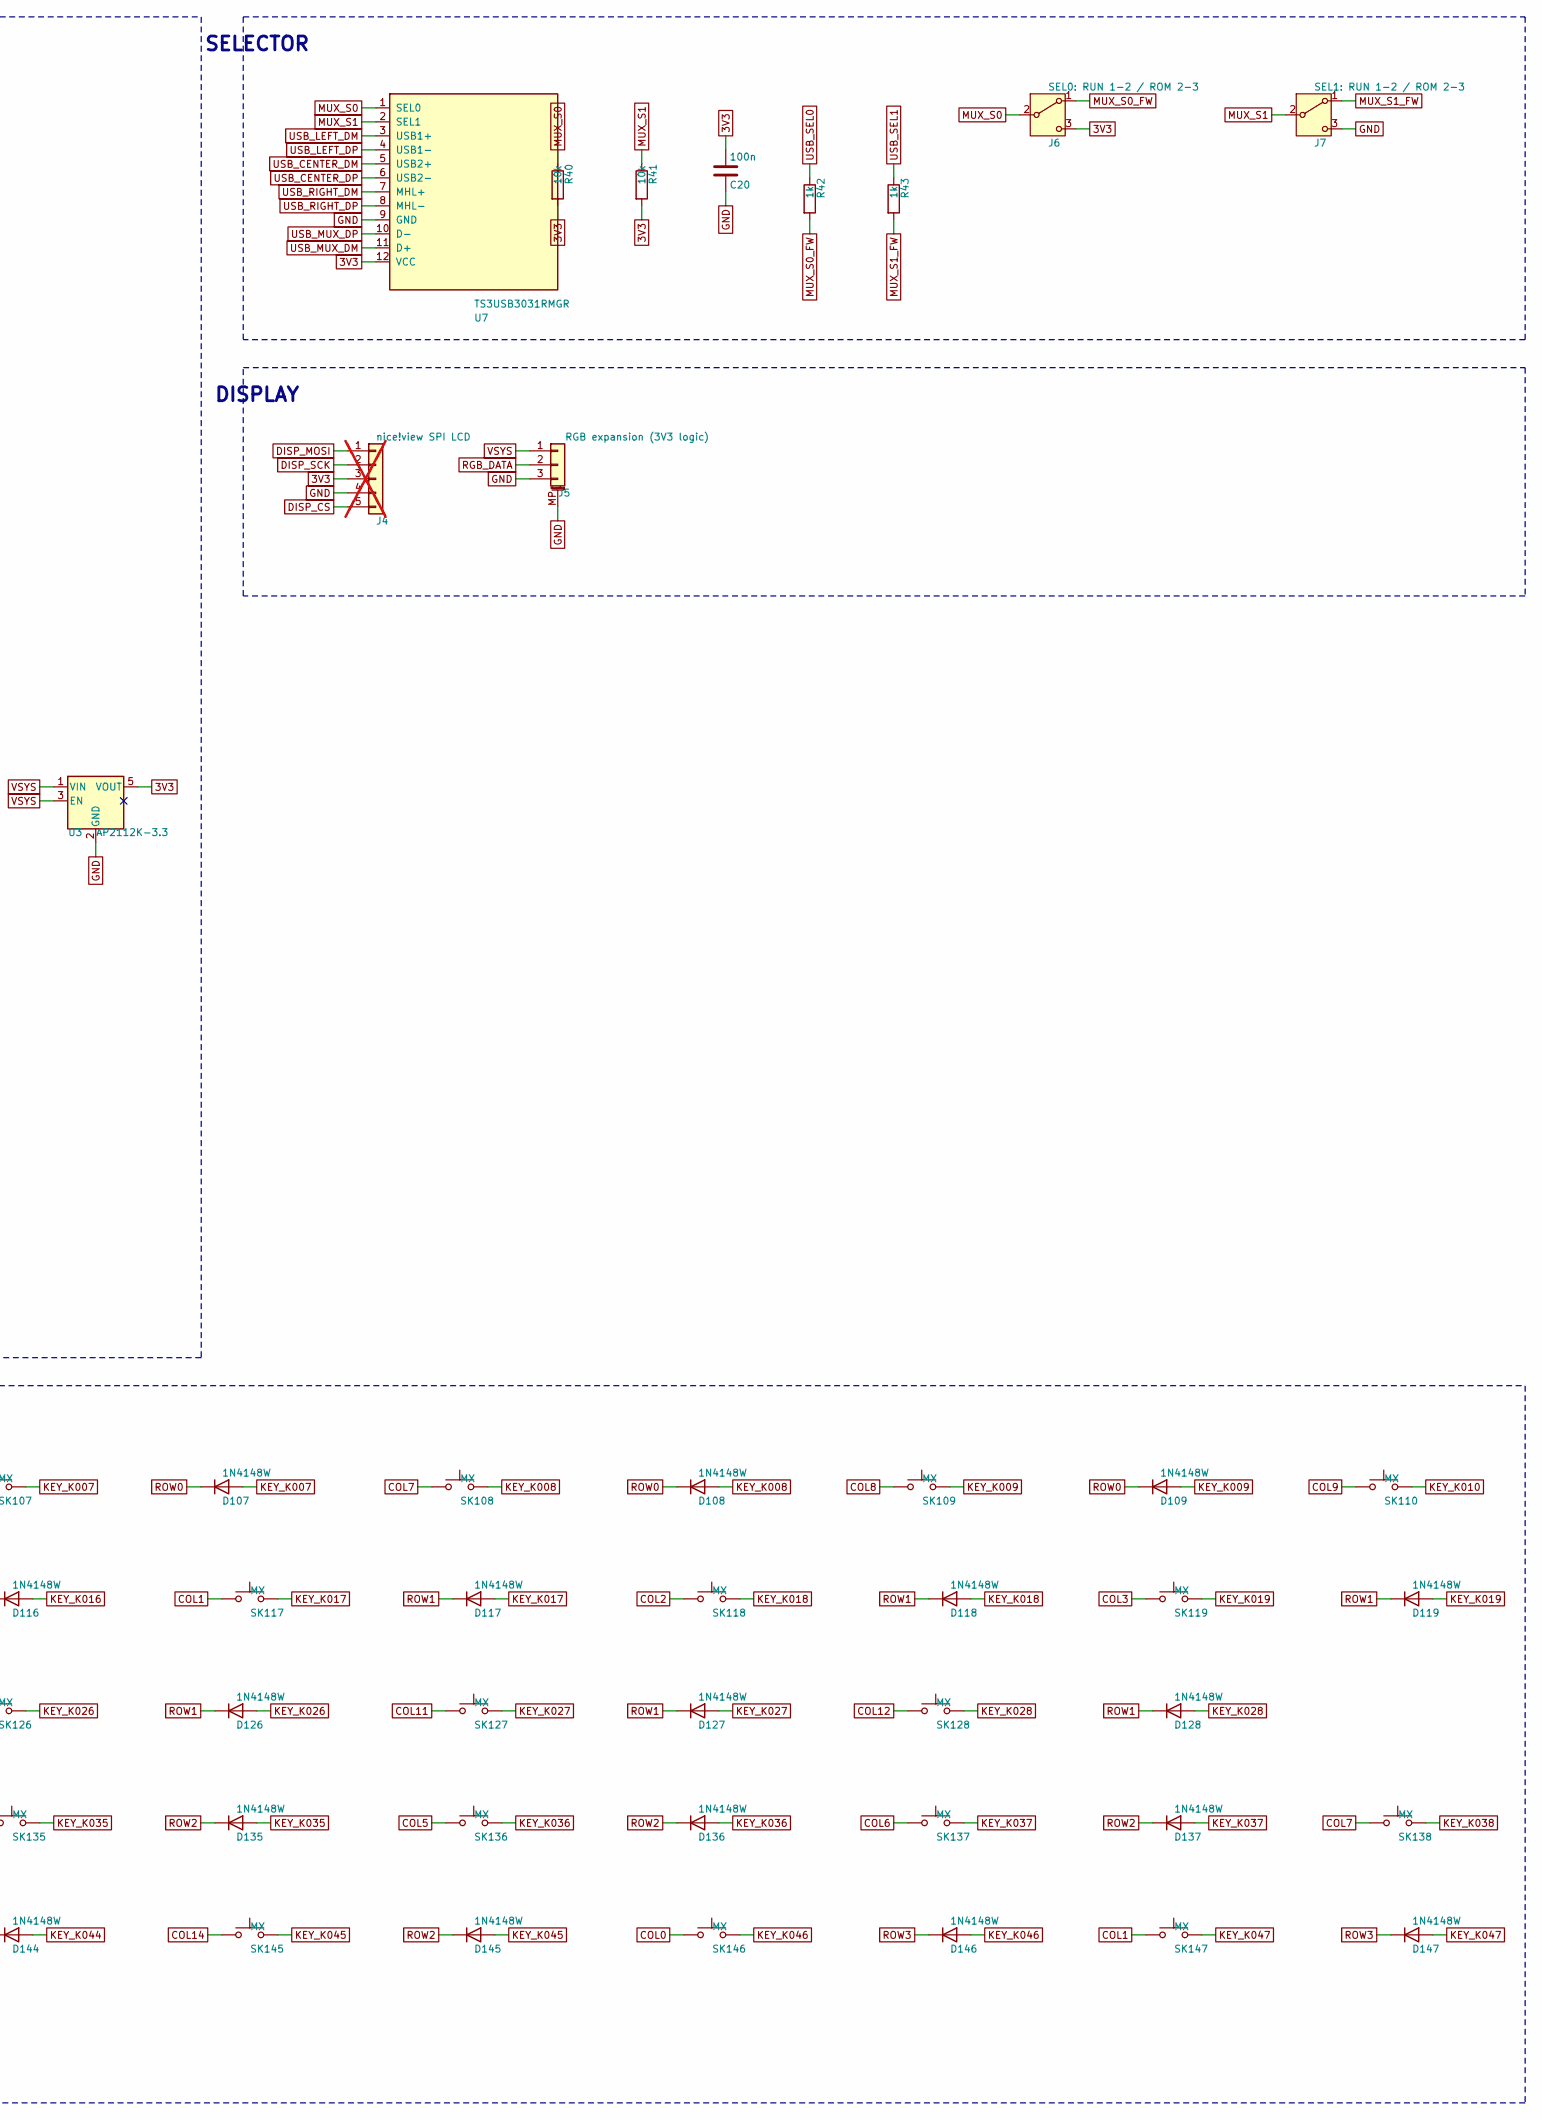
[picture p45: schematic worxboard-ergo-mx.kicad_sch, worxboard ergo mx A0 UNROUTED, part in row 1, column 3]

Parts:
C1, C2, C4, C18, C19: 1u; C_0402_1005Metric; LCSC C52923
C3: 10u; C_0402_1005Metric; LCSC C15525
C5, C8, C9, C10, C11, C12, C13, C14, C15, C16, C17, C20: 100n; C_0402_1005Metric; LCSC C1525
C6, C7: 27p; C_0402_1005Metric; LCSC C1557
D1, D2, D3: B5819W; D_SOD-123; LCSC C8598
D101, D102, D103, D104, D105, D106, D107, D108, D109, D110, D111, D112, D113, D114, D115, D116, D117, D118, D119, D120, D121, D122, D123, D124, D125, D126, D127, D128, D129, D130, D131, D132, D133, D134, D135, D136, D137, D138, D139, D140, D141, D142, D143, D144, D145, D146, D147, D148: 1N4148W; D_SOD-123; LCSC C81598
H1, H2, H3, H4, H5, H6, H7, H8: M2.5; MountingHole_2.7mm_M2.5
J1, J2, J3: TYPE-C-31-M-12; USB_C_Receptacle_HRO_TYPE-C-31-M-12; LCSC C165948
J4: nice!view SPI LCD; PinSocket_1x05_P2.54mm_Vertical_H5.0mm; not fitted
J5: RGB expansion (3V3 logic); JST_SH_SM03B-SRSS-TB_1x03-1MP_P1.00mm_Horizontal; LCSC C160403
J6: SEL0: RUN 1-2 / ROM 2-3; SW_SPDT_PCM12; LCSC C221841
J7: SEL1: RUN 1-2 / ROM 2-3; SW_SPDT_PCM12; LCSC C221841
R3, R4: 27; R_0402_1005Metric; LCSC C2909343
R7, R9, R42, R43: 1k; R_0402_1005Metric; LCSC C11702
R8, R10, R40, R41: 10k; R_0402_1005Metric; LCSC C25744
R25, R26, R27, R28, R30, R31, R32, R33, R35, R36, R37, R38: 5.1k; R_0402_1005Metric; LCSC C25905
SK101, SK102, SK103, SK104, SK105, SK106, SK107, SK108, SK109, SK110, SK111, SK112, SK113, SK114, SK115, SK116, SK117, SK118, SK119, SK120, SK121, SK122, SK123, SK124, SK125, SK126, SK127, SK128, SK129, SK130, SK131, SK132, SK133, SK134, SK135, SK136, SK137, SK138, SK139, SK140, SK141, SK142, SK143, SK144, SK145, SK146, SK147, SK148: MX; SW_MX_Hotswap_Kailh; LCSC C2803348
SW1: BOOT; SW_SPST_TS-1088-xR020; LCSC C455280
SW2: RESET; SW_SPST_TS-1088-xR020; LCSC C455280
TP8: SWCLK; TestPoint_Pad_D1.0mm
TP9: SWDIO; TestPoint_Pad_D1.0mm
TP10: GND; TestPoint_Pad_D1.0mm
U1: RP2040; QFN-56-1EP_7x7mm_P0.4mm_EP3.2x3.2mm; LCSC C2040
U2: W25Q128JVSIQ; SOIC-8_5.3x5.3mm_P1.27mm; LCSC C97521
U3: AP2112K-3.3; SOT-23-5; LCSC C51118
U4, U5, U6: USBLC6-2SC6; SOT-23-6; LCSC C7519
U7: TS3USB3031RMGR; Texas_RMG0012A_WQFN-12_1.8x1.8mm_P0.4mm; LCSC C2652459
Y1: 12MHz; Crystal_SMD_3225-4Pin_3.2x2.5mm; LCSC C49304726

Connections:
1V1: C16.1, C17.1, C19.1, U1.23 (DVDD), U1.45 (VREG_VOUT), U1.50 (DVDD)
3V3: C3.1, C4.1, C5.1, C8.1, C9.1, C10.1, C11.1, C12.1, C13.1, C14.1, C15.1, C18.1, C20.1, J4.3, J6.3 (C), R8.2, R10.2, R40.2, R41.2, U1.1 (IOVDD), U1.10 (IOVDD), U1.22 (IOVDD), U1.33 (IOVDD), U1.42 (IOVDD), U1.43 (ADC_AVDD), U1.44 (VREG_VIN), U1.48 (USB_VDD), U1.49 (IOVDD), U2.8 (VCC), U3.5 (VOUT), U7.12 (VCC)
BOOT: R9.2, SW1.1
CC1A: J1.A5 (CC1), R25.1
CC1B: J1.B5 (CC2), R26.1
CC2A: J2.A5 (CC1), R30.1
CC2B: J2.B5 (CC2), R31.1
CC3A: J3.A5 (CC1), R35.1
CC3B: J3.B5 (CC2), R36.1
COL0: SK101.1, SK116.1, SK131.1, SK146.1, U1.38 (GPIO26/ADC0)
COL1: SK102.1, SK117.1, SK132.1, SK147.1, U1.39 (GPIO27/ADC1)
COL2: SK103.1, SK118.1, SK133.1, SK148.1, U1.11 (GPIO8)
COL3: SK104.1, SK119.1, SK134.1, U1.12 (GPIO9)
COL4: SK105.1, SK120.1, SK135.1, U1.13 (GPIO10)
COL5: SK106.1, SK121.1, SK136.1, U1.14 (GPIO11)
COL6: SK107.1, SK122.1, SK137.1, U1.15 (GPIO12)
COL7: SK108.1, SK123.1, SK138.1, U1.16 (GPIO13)
COL8: SK109.1, SK124.1, SK139.1, U1.17 (GPIO14)
COL9: SK110.1, SK125.1, SK140.1, U1.18 (GPIO15)
COL10: SK111.1, SK126.1, SK141.1, U1.27 (GPIO16)
COL11: SK112.1, SK127.1, SK142.1, U1.28 (GPIO17)
COL12: SK113.1, SK128.1, SK143.1, U1.29 (GPIO18)
COL13: SK114.1, SK129.1, SK144.1, U1.30 (GPIO19)
COL14: SK115.1, SK130.1, SK145.1, U1.31 (GPIO20)
DISP_CS: J4.5, U1.7 (GPIO5)
DISP_MOSI: J4.1, U1.9 (GPIO7)
DISP_SCK: J4.2, U1.8 (GPIO6)
GND: C1.2, C2.2, C3.2, C4.2, C5.2, C6.2, C7.2, C8.2, C9.2, C10.2, C11.2, C12.2, C13.2, C14.2, C15.2, C16.2, C17.2, C18.2, C19.2, C20.2, J1.A1 (GND), J1.A12 (GND), J1.B1 (GND), J1.B12 (GND), J1.SH (SHIELD), J2.A1 (GND), J2.A12 (GND), J2.B1 (GND), J2.B12 (GND), J2.SH (SHIELD), J3.A1 (GND), J3.A12 (GND), J3.B1 (GND), J3.B12 (GND), J3.SH (SHIELD), J4.4, J5.3, J5.MP (MountPin), J7.3 (C), R25.2, R26.2, R28.2, R30.2, R31.2, R33.2, R35.2, R36.2, R38.2, SW1.2, SW2.2, TP10.1, U1.19 (TESTEN), U1.57 (GND), U2.4 (GND), U3.2 (GND), U4.2 (GND), U5.2 (GND), U6.2 (GND), U7.9 (GND), Y1.2 (G), Y1.4 (G)
KEY_K001: D101.2 (A), SK101.2
KEY_K002: D102.2 (A), SK102.2
KEY_K003: D103.2 (A), SK103.2
KEY_K004: D104.2 (A), SK104.2
KEY_K005: D105.2 (A), SK105.2
KEY_K006: D106.2 (A), SK106.2
KEY_K007: D107.2 (A), SK107.2
KEY_K008: D108.2 (A), SK108.2
KEY_K009: D109.2 (A), SK109.2
KEY_K010: D110.2 (A), SK110.2
KEY_K011: D111.2 (A), SK111.2
KEY_K012: D112.2 (A), SK112.2
KEY_K013: D113.2 (A), SK113.2
KEY_K014: D114.2 (A), SK114.2
KEY_K015: D115.2 (A), SK115.2
KEY_K016: D116.2 (A), SK116.2
KEY_K017: D117.2 (A), SK117.2
KEY_K018: D118.2 (A), SK118.2
KEY_K019: D119.2 (A), SK119.2
KEY_K020: D120.2 (A), SK120.2
KEY_K021: D121.2 (A), SK121.2
KEY_K022: D122.2 (A), SK122.2
KEY_K023: D123.2 (A), SK123.2
KEY_K024: D124.2 (A), SK124.2
KEY_K025: D125.2 (A), SK125.2
KEY_K026: D126.2 (A), SK126.2
KEY_K027: D127.2 (A), SK127.2
KEY_K028: D128.2 (A), SK128.2
KEY_K029: D129.2 (A), SK129.2
KEY_K030: D130.2 (A), SK130.2
KEY_K031: D131.2 (A), SK131.2
KEY_K032: D132.2 (A), SK132.2
KEY_K033: D133.2 (A), SK133.2
KEY_K034: D134.2 (A), SK134.2
KEY_K035: D135.2 (A), SK135.2
KEY_K036: D136.2 (A), SK136.2
KEY_K037: D137.2 (A), SK137.2
KEY_K038: D138.2 (A), SK138.2
KEY_K039: D139.2 (A), SK139.2
KEY_K040: D140.2 (A), SK140.2
KEY_K041: D141.2 (A), SK141.2
KEY_K042: D142.2 (A), SK142.2
KEY_K043: D143.2 (A), SK143.2
KEY_K044: D144.2 (A), SK144.2
KEY_K045: D145.2 (A), SK145.2
KEY_K046: D146.2 (A), SK146.2
KEY_K047: D147.2 (A), SK147.2
KEY_K048: D148.2 (A), SK148.2
MUX_S0: J6.2 (B), R40.1, U7.1 (SEL0)
MUX_S0_FW: J6.1 (A), R42.2
MUX_S1: J7.2 (B), R41.1, U7.2 (SEL1)
MUX_S1_FW: J7.1 (A), R43.2
QSPI_SCLK: U1.52 (QSPI_SCLK), U2.6 (CLK)
QSPI_SD0: U1.53 (QSPI_SD0), U2.5 (DI/IO_{0})
QSPI_SD1: U1.55 (QSPI_SD1), U2.2 (DO/IO_{1})
QSPI_SD2: U1.54 (QSPI_SD2), U2.3 (~WP/IO_{2})
QSPI_SD3: U1.51 (QSPI_SD3), U2.7 (~HOLD/~RESET/IO_{3})
QSPI_SS: R8.1, R9.1, U1.56 (~QSPI_SS), U2.1 (~CS)
RGB_DATA: J5.2, U1.41 (GPIO29/ADC3)
ROW0: D101.1 (K), D102.1 (K), D103.1 (K), D104.1 (K), D105.1 (K), D106.1 (K), D107.1 (K), D108.1 (K), D109.1 (K), D110.1 (K), D111.1 (K), D112.1 (K), D113.1 (K), D114.1 (K), D115.1 (K), U1.2 (GPIO0)
ROW1: D116.1 (K), D117.1 (K), D118.1 (K), D119.1 (K), D120.1 (K), D121.1 (K), D122.1 (K), D123.1 (K), D124.1 (K), D125.1 (K), D126.1 (K), D127.1 (K), D128.1 (K), D129.1 (K), D130.1 (K), U1.3 (GPIO1)
ROW2: D131.1 (K), D132.1 (K), D133.1 (K), D134.1 (K), D135.1 (K), D136.1 (K), D137.1 (K), D138.1 (K), D139.1 (K), D140.1 (K), D141.1 (K), D142.1 (K), D143.1 (K), D144.1 (K), D145.1 (K), U1.4 (GPIO2)
ROW3: D146.1 (K), D147.1 (K), D148.1 (K), U1.5 (GPIO3)
RUN: R10.1, SW2.1, U1.26 (RUN)
SWCLK: TP8.1, U1.24 (SWCLK)
SWDIO: TP9.1, U1.25 (SWDIO)
USB_CENTER_DM: J2.A7 (D-), J2.B7 (D-), U5.3 (I/O2), U5.4 (I/O2), U7.5 (USB2+)
USB_CENTER_DP: J2.A6 (D+), J2.B6 (D+), U5.1 (I/O1), U5.6 (I/O1), U7.6 (USB2-)
USB_DM: R4.2, U1.46 (USB_DM)
USB_DP: R3.2, U1.47 (USB_DP)
USB_LEFT_DM: J1.A7 (D-), J1.B7 (D-), U4.3 (I/O2), U4.4 (I/O2), U7.3 (USB1+)
USB_LEFT_DP: J1.A6 (D+), J1.B6 (D+), U4.1 (I/O1), U4.6 (I/O1), U7.4 (USB1-)
USB_MUX_DM: R4.1, U7.11 (D+)
USB_MUX_DP: R3.1, U7.10 (D-)
USB_RIGHT_DM: J3.A7 (D-), J3.B7 (D-), U6.3 (I/O2), U6.4 (I/O2), U7.7 (MHL+)
USB_RIGHT_DP: J3.A6 (D+), J3.B6 (D+), U6.1 (I/O1), U6.6 (I/O1), U7.8 (MHL-)
USB_SEL0: R42.1, U1.32 (GPIO21)
USB_SEL1: R43.1, U1.34 (GPIO22)
VBUS_CENTER: D2.2 (A), J2.A4 (VBUS), J2.A9 (VBUS), J2.B4 (VBUS), J2.B9 (VBUS), R32.1, U5.5 (VBUS)
VBUS_CENTER_SENSE: R32.2, R33.1, U1.36 (GPIO24)
VBUS_LEFT: D1.2 (A), J1.A4 (VBUS), J1.A9 (VBUS), J1.B4 (VBUS), J1.B9 (VBUS), R27.1, U4.5 (VBUS)
VBUS_LEFT_SENSE: R27.2, R28.1, U1.35 (GPIO23)
VBUS_RIGHT: D3.2 (A), J3.A4 (VBUS), J3.A9 (VBUS), J3.B4 (VBUS), J3.B9 (VBUS), R37.1, U6.5 (VBUS)
VBUS_RIGHT_SENSE: R37.2, R38.1, U1.37 (GPIO25)
VSYS: C1.1, C2.1, D1.1 (K), D2.1 (K), D3.1 (K), J5.1, U3.1 (VIN), U3.3 (EN)
XIN: C6.1, U1.20 (XIN), Y1.1
XOUT: R7.2, U1.21 (XOUT)
XTAL_OUT: C7.1, R7.1, Y1.3

Notes on the sheet:
MCU
USB-POWER
SELECTOR
DISPLAY
MATRIX

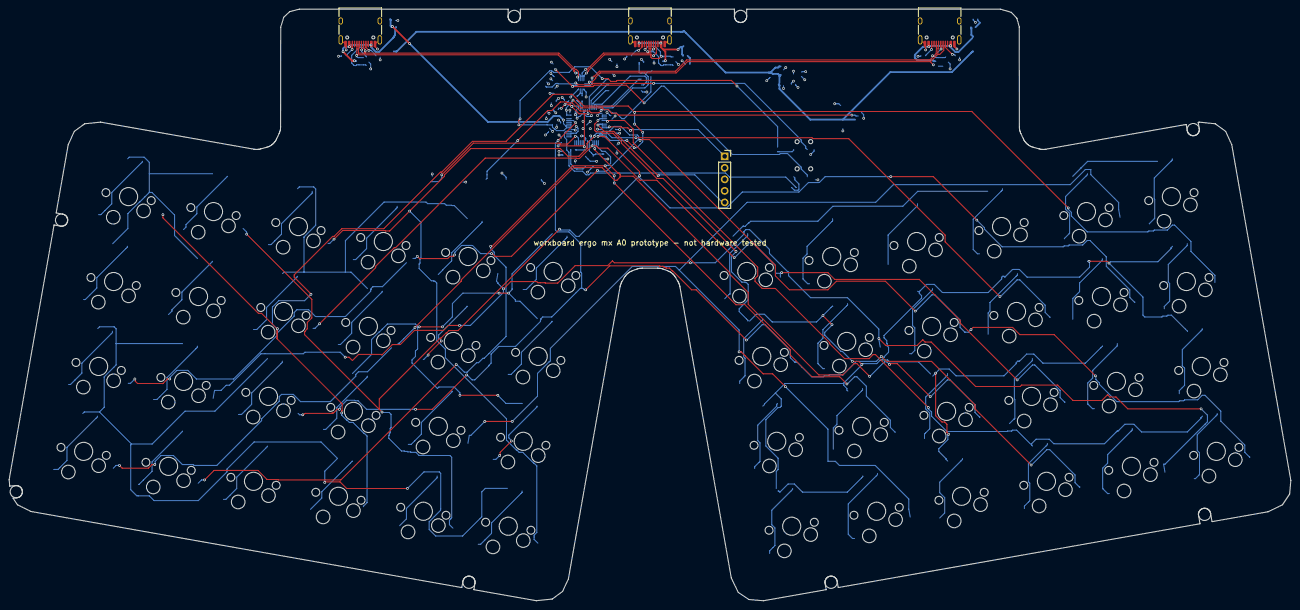
[picture p46: board worxboard-ergo-mx.kicad_pcb from above]

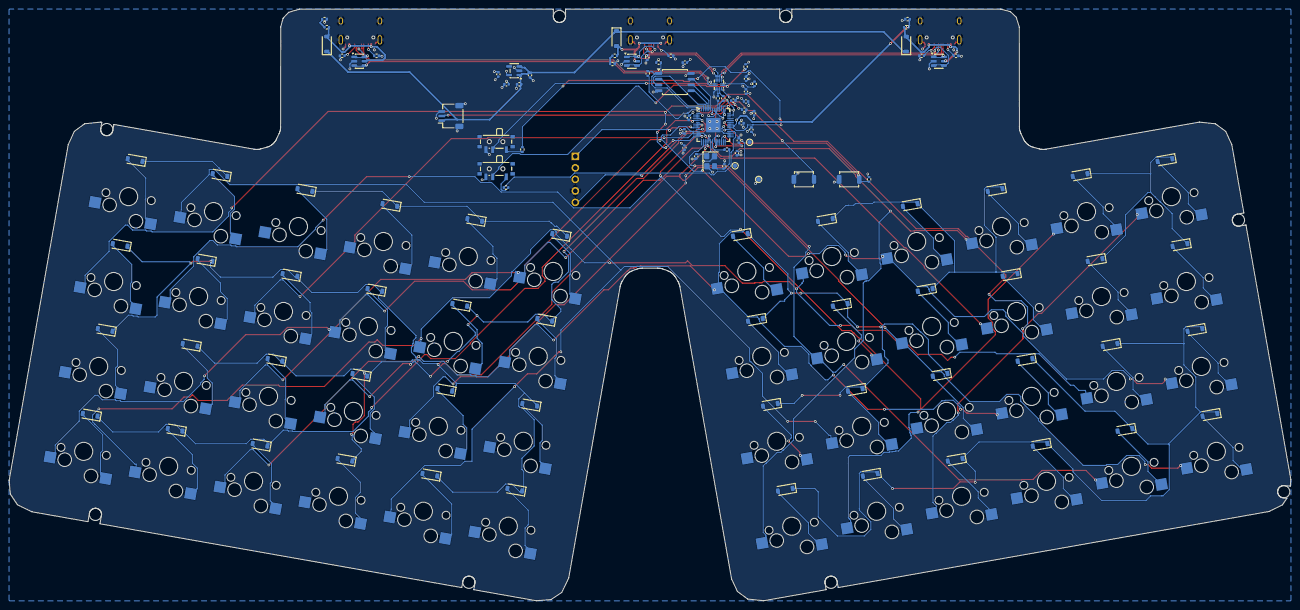
[picture p47: board worxboard-ergo-mx.kicad_pcb from below]

Board: 4 copper layers, 283.1 x 130.7 mm, 169 parts (157 on the bottom side), 116 nets.
