w0rxbend/worxboard-ergo/(commit log)

2026-11-06 feat: initialize ergonomic RP2040 keyboard design workflow
    [assembly.step, bom.csv, display_bezel.3mf, display_bezel.step, display_bezel.stl, palm_rest.3mf, palm_rest.step, palm_rest.stl]
2026-11-08 feat: replace the TKL with a 48-key split Planck
    Two 4×6 wells splay ten degrees on one rigid deck, with a low rear bay and a short palm rest. Regenerated CAD, placement, keymap, and the A0 checks. Added the shop guide and a microsite. The boards stay unrouted.
    [assembly.step, bom.csv, chassis.3mf, chassis.step, chassis.stl, chassis_left.3mf, chassis_left.step, chassis_left.stl]
2026-11-13 feat: wrap the deck in a Sculpt-style shell
    Replace the Launch-style tray with a curved shell: a tangent-arc plan
    outline, a 67 mm palm rest, an open valley slot, a flush top cover that
    takes over the display window, and an optional magnetic riser for 6.7
    degrees of negative tilt. Key positions, key order and the PCB are
    unchanged.
    Exports were mirrored against the PCB because the model used a
    left-handed frame. Every part now passes through to_cad_frame, and the
    tests probe the eight shared holes against pcb/*/placement.json.
    The fit gate now covers USB receptacle and plug keep-outs, switch
    housings, keycap travel and the LCD pocket. display_bezel is removed;
    top_cover and riser are new p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
    [assembly.step, chassis.3mf, chassis.step, chassis.stl, chassis_left.3mf, chassis_left.step, chassis_left.stl, chassis_right.3mf]
2026-11-13 docs: add a 3D print guide, docs index and changelog
    Rewrite the README around what a reader can do at A0: print the case,
    read the circuit, and not order the PCB. Move the print steps out of
    the build guide into docs/printing.md so there is one copy.
2026-11-13 feat(site): rebuild the product page around CAD renders
    Replace the stale deck drawing in the hero with renders from the
    parametric model, written by tools/render.py. The layer switcher stays
    and no longer draws the earlier short palm rest. Drop the unused
    Fraunces font. Publish site/ with GitHub Pages.
    Renders show envelope CAD. The page says so, and states that the PCB
    cannot be ordered.
    [render.py]
2026-11-13 feat(site): path-traced renders with real keycaps
    Replace the block-keycap CAD screenshots for the hero, top, side and
    rear shots with path-traced renders: sculpted caps with base-layer
    legends, the display reading BASE, and studio lighting. WebP copies
    ship beside the PNGs.
    Work in progress: the Choc and exploded shots still use the earlier
    renderer. These are renders of a design that has not been built.
    [render.py, render_parts.py]
2026-11-13 feat(cad): engrave the owner's signature in the chassis underside
    Cut "Oleksandr", a one-stroke flourish for the B, and "Signature
    Edition" 0.4 mm deep under the right well, mirrored so it reads from
    below. Every stroke is a tool centre line of constant width, so a
    0.8 mm or 0.5 mm cutter follows it in one pass. 2.0 mm of floor stays.
    Letter strokes come from the Hershey single-line fonts through the
    pinned Hershey-Fonts package; THIRD_PARTY.md carries the notice.
    The floor test now allows the groove depth where the signature passes
    under a switch, and a new test checks the groove is open, the floor
    above it is whole, and it stays 5 mm clear of holes, pads and magnets.
    Verified: make cad,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
    [assembly.step, chassis.3mf, chassis.step, chassis.stl, chassis_left.3mf, chassis_left.step, chassis_right.3mf, chassis_right.step]
2026-11-13 feat: make the signature a laser engraving, not a milled groove
    Replace the 0.4 mm milled signature with laser artwork for the chassis
    underside. The mark is a surface engraving, so it leaves the solid
    model and the 2.4 mm floor untouched; this reverts the CAD, test and
    dependency changes of 3d1a14f.
    tools/signature.py writes filled vector outlines to cad/exports/laser:
    the signature alone and a 1:1 placement drawing of the underside seen
    from below, each as SVG, PDF and a 4000 px PNG. The name is set in
    Mrs Saint Delafield, the edition line in Michroma, both under the SIL
    Open Font License and vendored in assets/fonts. The B is a brush
    stroke with a tapered tail. The tool fails if the artw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
    [assembly.step, chassis.3mf, chassis.step, chassis.stl, chassis_left.3mf, chassis_left.step, chassis_right.3mf, chassis_right.step]
2026-11-13 feat: make the engraved name heavier
    The script font's hairlines were 0.1 to 0.2 mm wide at this size, too
    light for a coarse laser. Flatten the name outlines and grow them
    0.18 mm on every side, and widen the flourish pen to 0.95 mm to match.
    Verified: make laser, checksums. The solid model is unchanged, so the
    geometry tests were not rerun.
2026-11-13 feat(site): show the full set of path-traced renders
    Wire the finished renders into the product page: the Choc variant, an
    exploded view with switches and PCB, the rear wall with its three
    USB-C openings, the riser stance, and three close-ups. The page uses
    the full-size WebP files; the PNGs stay for the README and link
    previews.
    The case parts in the renders come from the CAD model. Keycaps,
    legends, switch housings, the plain PCB and the colours are drawn for
    the picture only; docs/verification.md says so.
2026-11-13 wip(pcb): place support parts, turn USB jacks, route critical nets
    Work in progress toward routed boards and a PCBWay order package.
    This commit records the state so far; the boards are NOT routed and
    must not be ordered.
    Done:
    - Support parts moved next to the RP2040, flash, crystal, regulator
    and connectors. The three USB-C receptacles now face the rear wall.
    - Mounting holes moved inside the board edge (layout/model.py); case
    geometry, layout assets and CAD exports regenerated to match.
    - pcb/scripts/route.py routes the critical nets by script: USB pairs
    and mux, crystal, QSPI flash, VBUS/VSYS/3V3/GND stubs. 386 tracks
    on MX, 404 on Choc, in pcb/.work only.
    - tools/pcb_autoroute.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
    [assembly.step, chassis.3mf, chassis.step, chassis.stl, chassis_left.3mf, chassis_left.step, chassis_left.stl, chassis_right.3mf]
2026-11-13 wip(pcb): autoroute the MX key matrix and start the fab scripts
    Work in progress. The committed .kicad_pcb files still have zero
    tracks and must not be ordered.
    - pcb/mx/autoroute.ses and autoroute.json: a Freerouting session for
    the MX board, so make pcb can replay it without Java or network.
    Not yet merged into the board or checked by DRC.
    - route.py, maze.py, design.py, support_places.py and both hot-swap
    footprints changed while fixing autorouter fanout failures.
    - fab.py and tools/pcb_fab.sh extended toward the PCBWay package.
    No Gerbers yet.
    - Docs (assembly, build, electrical, pcb-seed, roadmap, verification)
    partly updated for the new placement; they may still describe
    u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
    [worxboard-ergo-mx.kicad_sch]
2026-11-14 fix: tell the truth about the PCB and make the tests pass again
    Two work-in-progress commits (eeea447, 69d5e99) carried doc edits
    that described routed boards and a PCBWay package. Neither exists:
    both committed boards still have zero tracks. Restore assembly.md,
    build.md, pcb-seed.md, roadmap.md and verification.md to their last
    accurate text, then record the real routing status: critical nets
    scripted and DRC-clean on MX, key matrix and RP2040 fan-out open,
    Choc not started, stale ERC/DRC reports, no fab package. Keep the
    corrected electrical.md (4x15 matrix, GP4/5 free, 48 LEDs).
    Mark test_committed_pcb_reports_are_clean as a strict expected
    failure until the boards are routed; strict, s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
    [assembly.step, chassis.3mf, chassis.step, chassis_left.3mf, chassis_left.step, chassis_right.3mf, chassis_right.step, palm_rest.3mf]
2026-11-14 feat(pcb): move display to SPI0, generate board pins, add rip-up routing
    - Display on SPI0 (CS GP5, SCK GP6, MOSI GP7); COL0/COL1 on GP26/27,
    so the display pins face J4. GP4 and GP28 are free.
    - tools/firmware_layout.py now writes worxboard-ergo-pins.dtsi from
    GPIO_NETS; a contract test fails if the two drift.
    - Pinned ZMK build passes on the new map. Not hardware tested.
    - J6/J7 become C&K PCM12 slide switches, J5 a JST SH 3-pin, both on
    B.Cu. J4 stays a hand-fitted footprint: no real nice!view stack fits
    the modeled display pocket.
    - Router: rip-up and retry on grid routes, resumable grid stage.
    The boards are still unrouted. No DRC-clean claim, no fab package.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
    [bom.csv, worxboard-ergo-mx.kicad_sch]
2026-11-14 fix(firmware): add the generated board pins file
    The previous commit includes it from the .dts but did not add it.
2026-11-14 wip(pcb): route most of the MX board
    2326 tracks and 242 vias. Unconnected items drop from 329 to 28.
    ERC is clean and pin parity matches (459 pads).
    Not DRC-clean. 6 errors: a 1V1/GND short under U1, two COL13 tracks
    too close to the board edge, and a too-thin USB_SEL1 stub. SWDIO,
    SWCLK, ROW0, ROW1 and the VBUS sense nets cannot escape U1 on this
    placement. Choc is still unrouted. Do not order this board.
    [worxboard-ergo-mx.kicad_pcb]
2026-11-14 wip(pcb): stop mid-run with the MX placement fixes in progress
    The owner stopped the work here. Router and placement changes are
    partly applied: TP8/TP9, the sense dividers, and the edge keep-out.
    The routed board in pcb/mx is still the 3e80855 result. The
    placement, net and routing report come from a run that was cut off,
    so they do not match that board. Rerun `make pcb` and the router
    before you trust any report here. Not DRC-clean. Do not order.
    [route.py, support_places.py]
