w0rxbend/worxboard-ergo/(notices)

Notices in the files:
README.md:
License: GPL-3.0-or-later
